mattock/cheiroballistra/README.md

cheiroballistra
===============

Various data related to the cheiroballistra project, such as CAD drawings, wiki 
backups and statistics.

The project wiki is located here:

* http://ballista.wikia.com

And the blog is here:

* http://ballista.wikia.com/wiki/User_blog:Samuli.seppanen
