mattock/cheiroballistra/articles/Juhlakirja/Seppänen, Samuli 2015 - The Cheiroballistra - Abstract.odt

This abstract was originally written for Academia.edu

This paper talks about the challenges of reconstructing the cheiroballistra - a Roman torsion weapon - based on historical manuscripts and archaeological finds. Basic usage of the weapon is also covered. While the reconstruction is already quite powerful, increasing the power output by about 50% should be doable. This will put the weapon roughly in the same category with medieval heavy crossbows, but with much improved rate of fire.
