mattock/cheiroballistra/articles/Juhlakirja/320hz ballista overview 1 - large.png

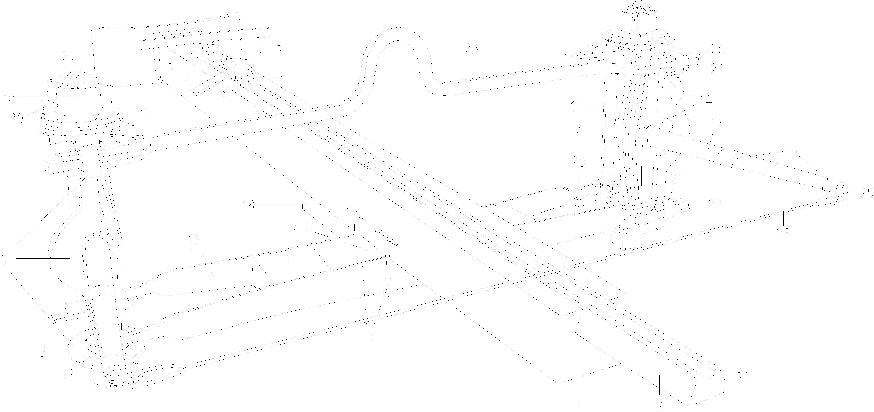
articles/Juhlakirja/320hz ballista overview 1 - large.png
