mattock/cheiroballistra/articles/Juhlakirja/320hz ballista overview 2 - large.png

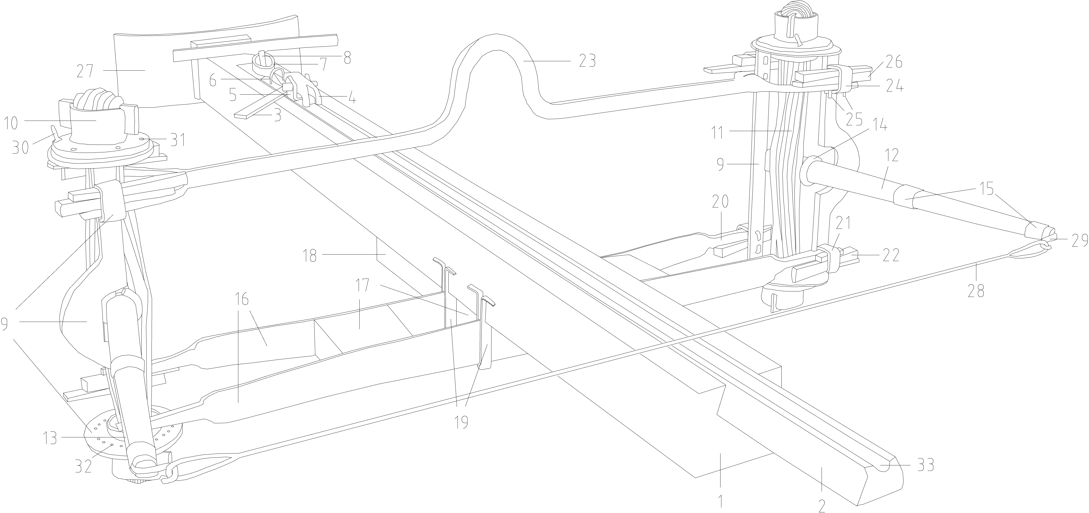
articles/Juhlakirja/320hz ballista overview 2 - large.png
