mattock/cheiroballistra/export/visualization/Cheiroballistra 11 dactyl arm design.png

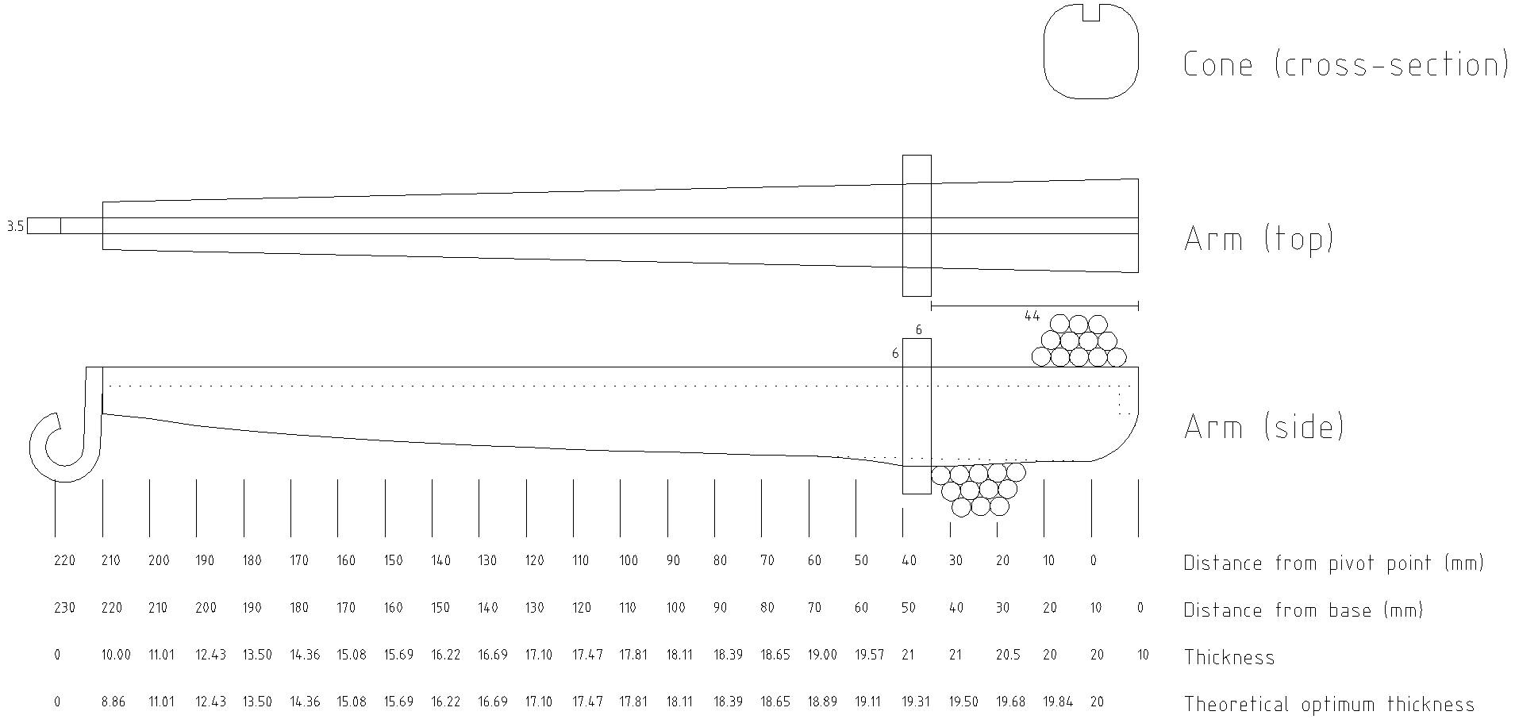
export/visualization/Cheiroballistra 11 dactyl arm design.png
