mattock/cheiroballistra/export/visualization/Cheiroballistra 14 dactyl arm design.png

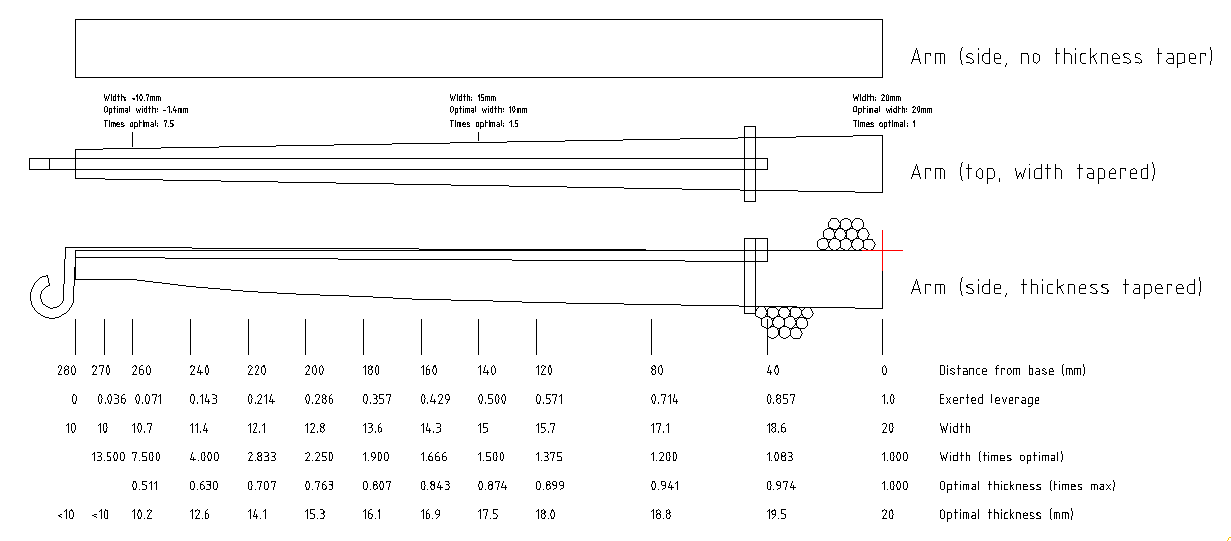
export/visualization/Cheiroballistra 14 dactyl arm design.png
