mattock/cheiroballistra/export/visualization/Cheiroballistra force-draw curves.png

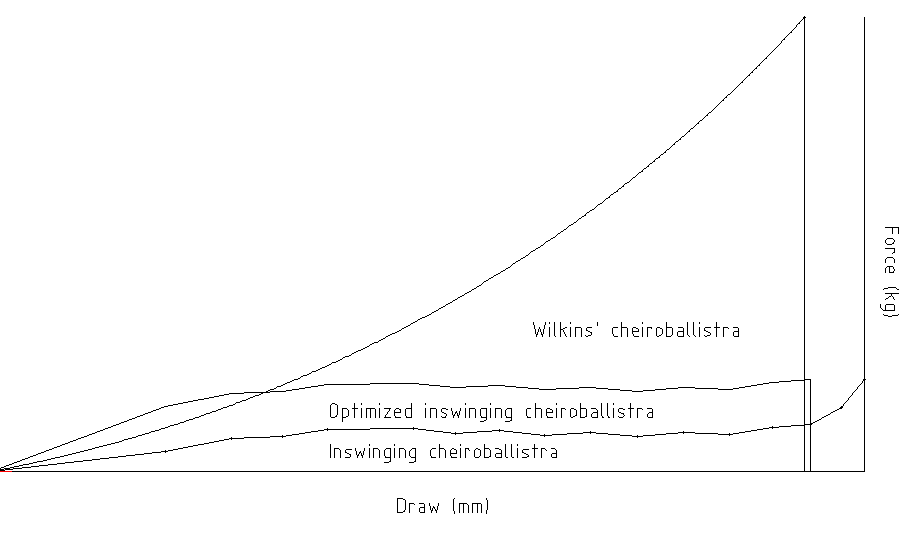
export/visualization/Cheiroballistra force-draw curves.png
