mattock/cheiroballistra/export/visualization/Forces acting on the little arch.png

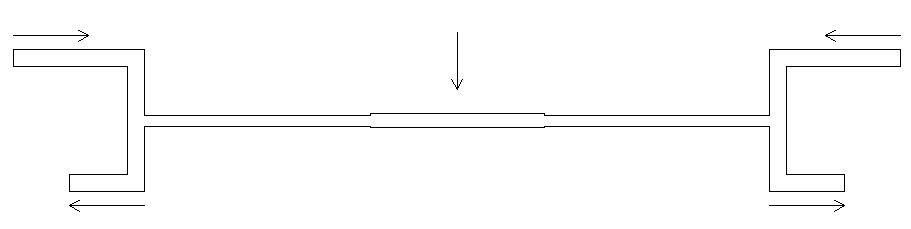
export/visualization/Forces acting on the little arch.png
