mattock/cheiroballistra/export/visualization/Forces acting on the little ladder.png

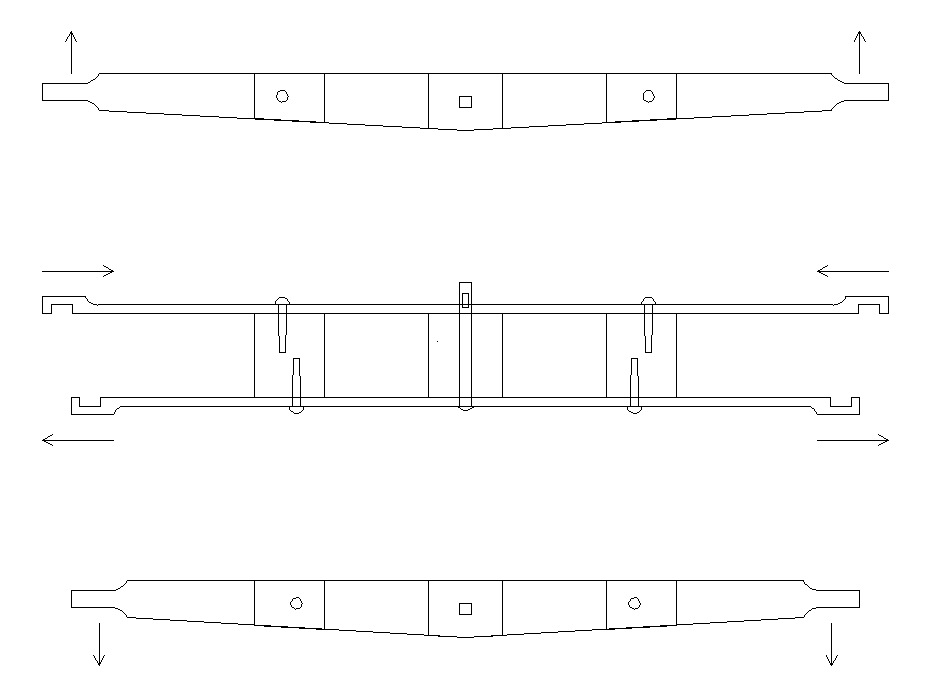
export/visualization/Forces acting on the little ladder.png
