mattock/cheiroballistra/export/visualization/Inswinging_cheiroballistra_arm_travel.png

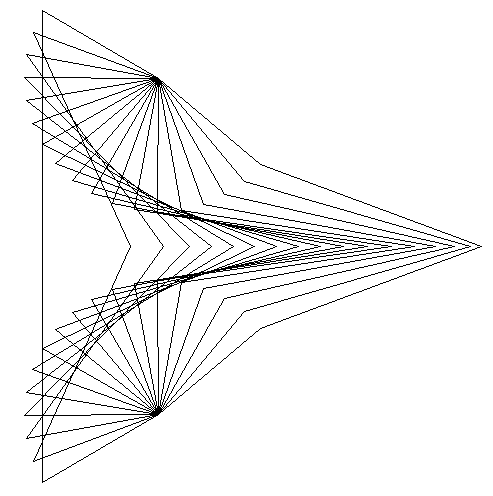
export/visualization/Inswinging_cheiroballistra_arm_travel.png
