mattock/cheiroballistra/export/visualization/Inswinging_cheiroballistra_bowstring_travel.png

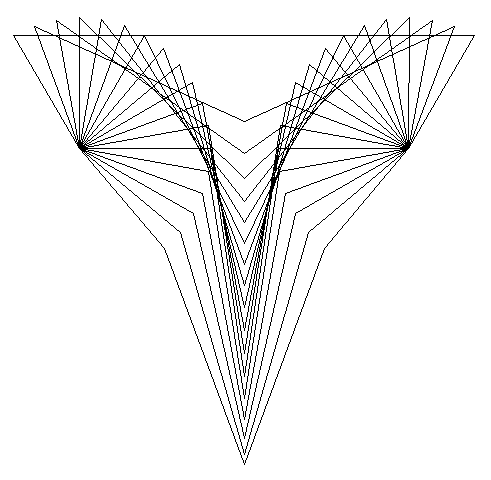
export/visualization/Inswinging_cheiroballistra_bowstring_travel.png
