mattock/cheiroballistra/export/visualization/outswinger visualization.png

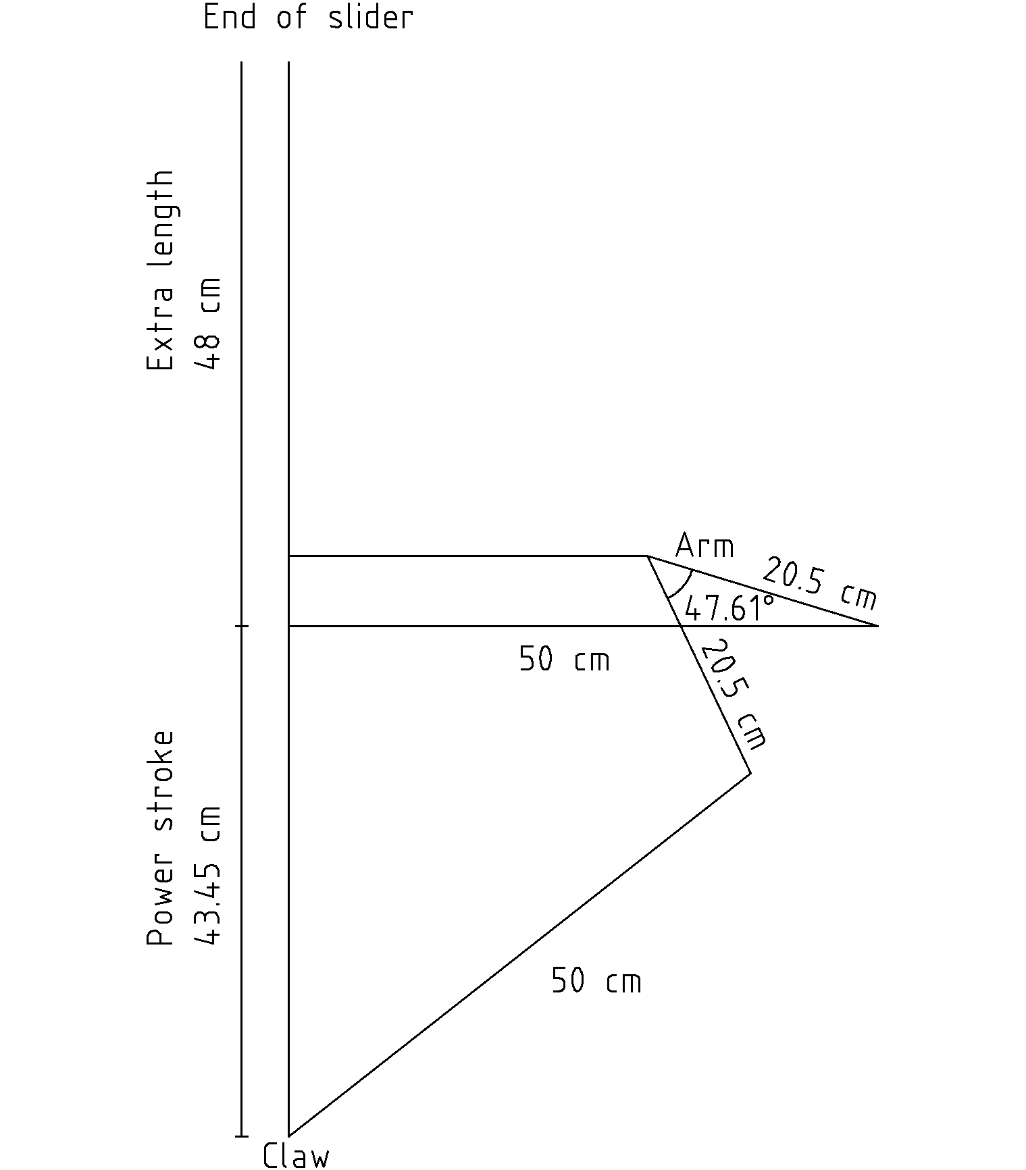
export/visualization/outswinger visualization.png
