mattock/cheiroballistra/export/visualization/Wilkins-cheiroballistra-force-draw-curve.png

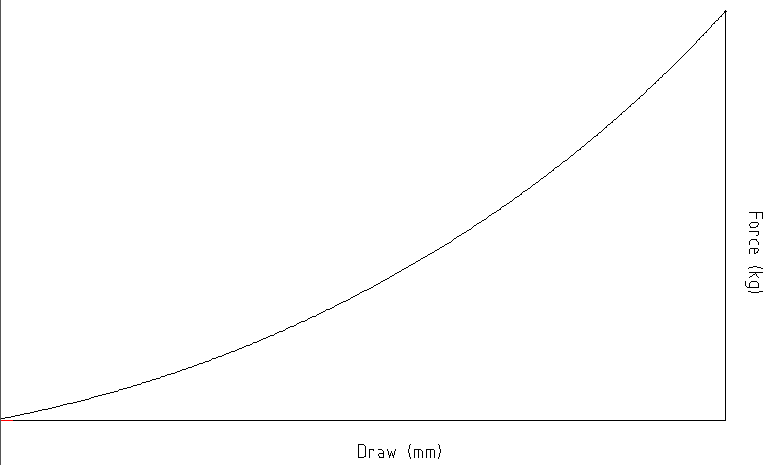
export/visualization/Wilkins-cheiroballistra-force-draw-curve.png
