mattock/cheiroballistra/export/parts/Cheiroballistra arm.png

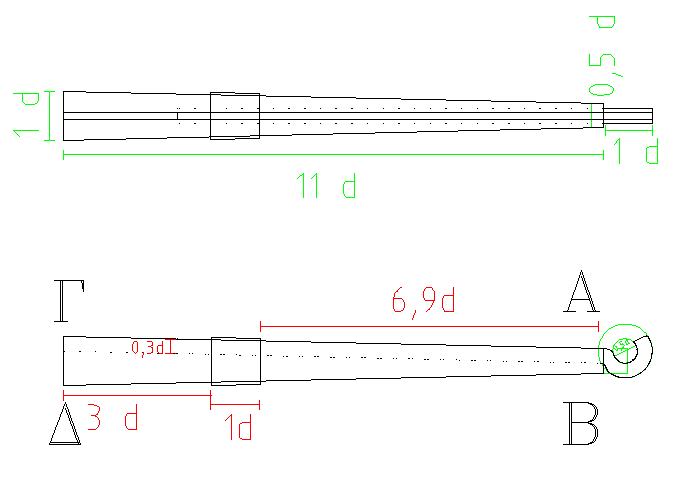
export/parts/Cheiroballistra arm.png
