mattock/cheiroballistra/export/parts/Cheiroballistra case - front.png

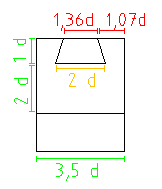
export/parts/Cheiroballistra case - front.png
