mattock/cheiroballistra/export/parts/Cheiroballistra case.png

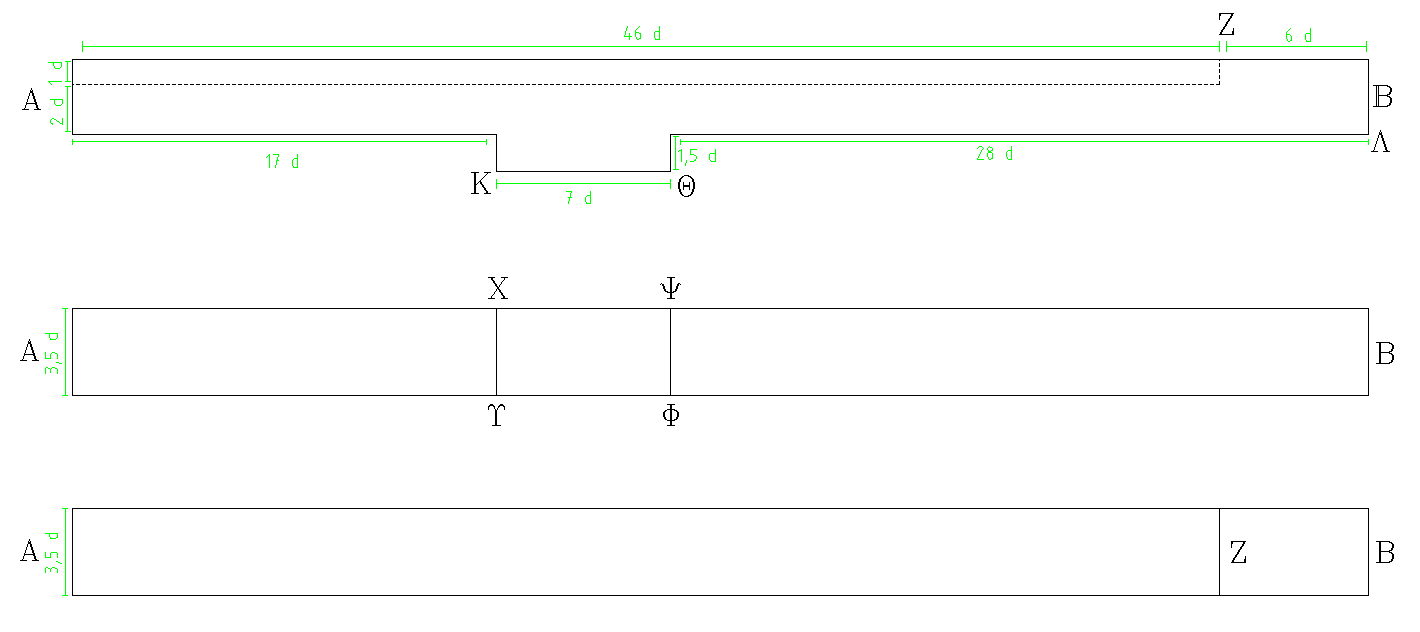
export/parts/Cheiroballistra case.png
