mattock/cheiroballistra/export/parts/Cheiroballistra slider.png

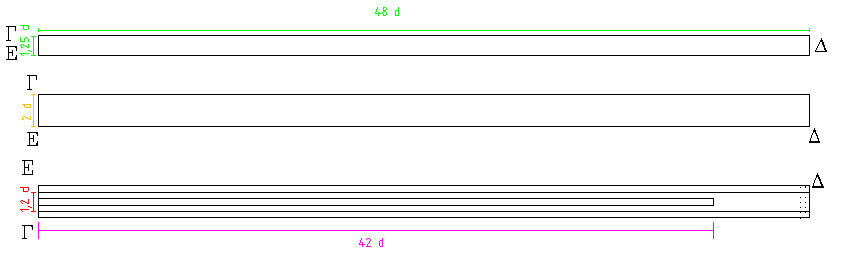
export/parts/Cheiroballistra slider.png
