mattock/cheiroballistra/export/parts/Cheiroballistra_alternative_rungs.png

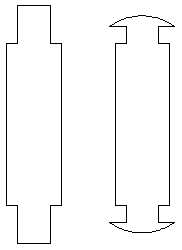
export/parts/Cheiroballistra_alternative_rungs.png
