mattock/cheiroballistra/export/parts/Cheiroballistra_Claw.png

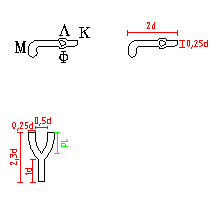
export/parts/Cheiroballistra_Claw.png
