mattock/cheiroballistra/export/parts/Cheiroballistra_Crescent_shaped_piece.png

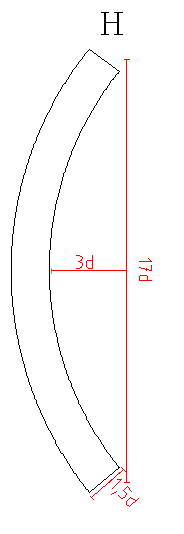
export/parts/Cheiroballistra_Crescent_shaped_piece.png
