mattock/cheiroballistra/export/parts/Cheiroballistra_Field-frame_bars.png

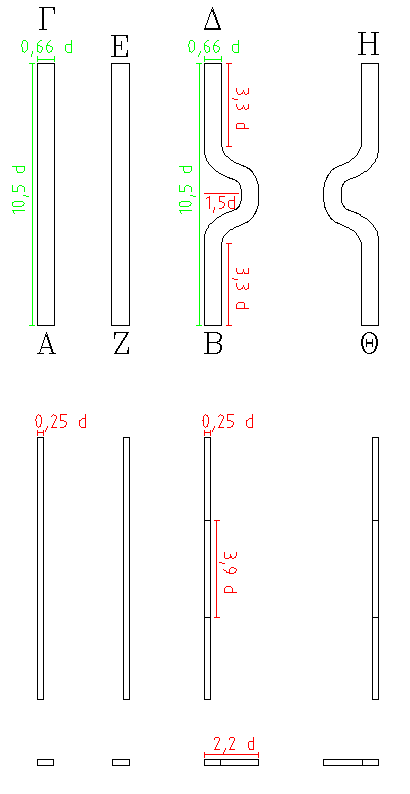
export/parts/Cheiroballistra_Field-frame_bars.png
