mattock/cheiroballistra/export/parts/Cheiroballistra_Field-frame_rings.png

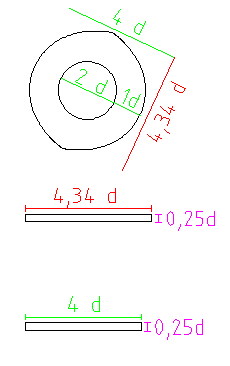
export/parts/Cheiroballistra_Field-frame_rings.png
