mattock/cheiroballistra/export/parts/Cheiroballistra_Fork.png

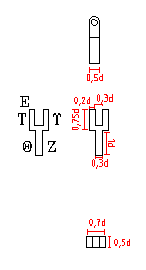
export/parts/Cheiroballistra_Fork.png
