mattock/cheiroballistra/export/parts/Cheiroballistra_front.png

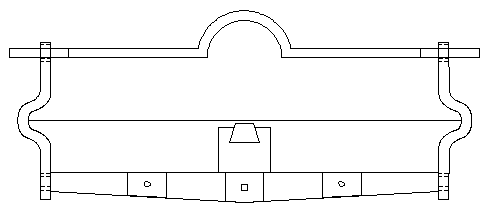
export/parts/Cheiroballistra_front.png
