mattock/cheiroballistra/export/parts/Cheiroballistra_Handle.png

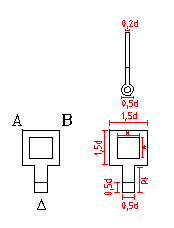
export/parts/Cheiroballistra_Handle.png
