mattock/cheiroballistra/export/parts/Cheiroballistra_Little_Arch.png

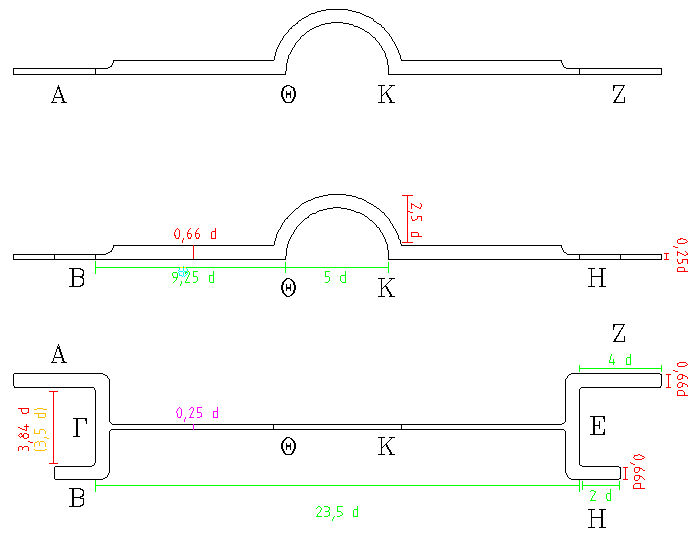
export/parts/Cheiroballistra_Little_Arch.png
