mattock/cheiroballistra/export/parts/Cheiroballistra_Little_Ladder - back and side.png

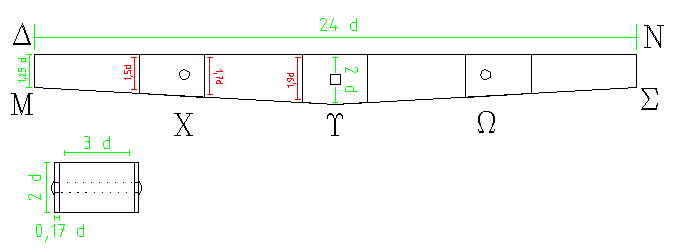
export/parts/Cheiroballistra_Little_Ladder - back and side.png
