mattock/cheiroballistra/export/parts/Cheiroballistra_Little_Ladder - front and top.png

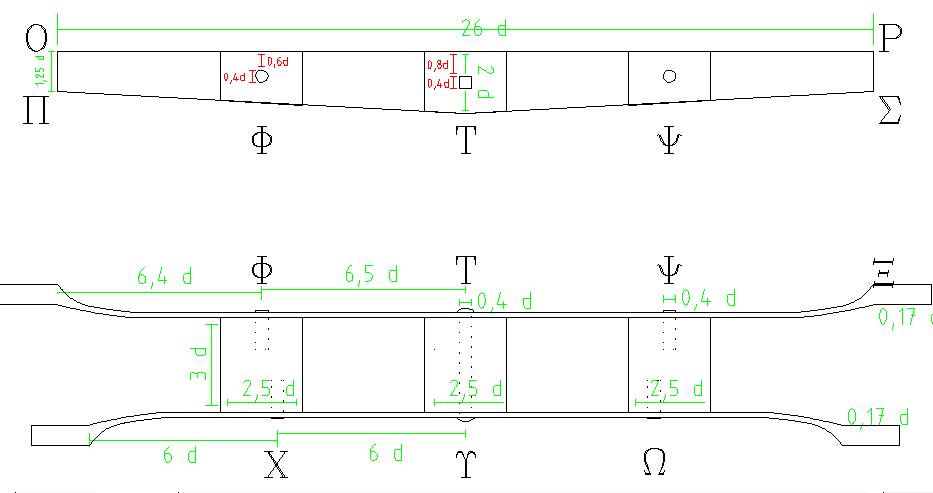
export/parts/Cheiroballistra_Little_Ladder - front and top.png
