mattock/cheiroballistra/export/parts/Cheiroballistra_Little_Ladder.png

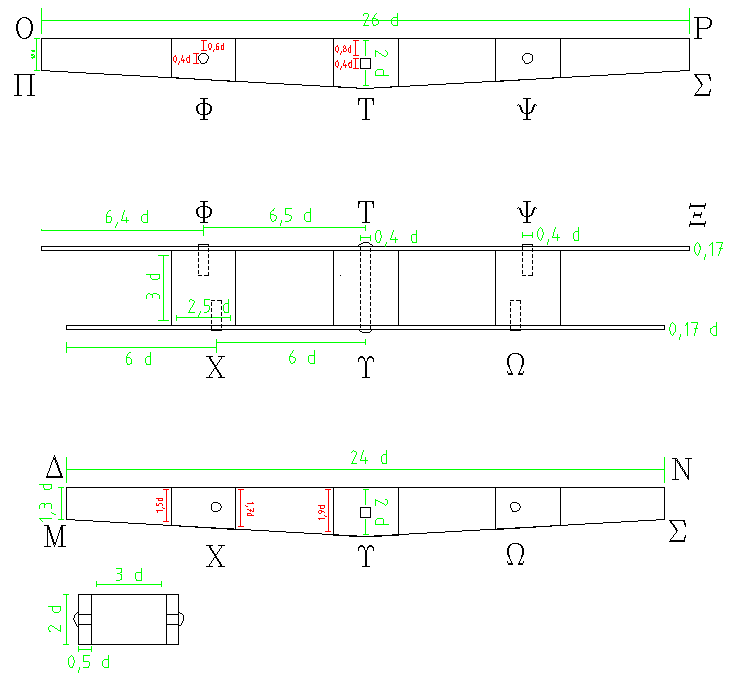
export/parts/Cheiroballistra_Little_Ladder.png
