mattock/cheiroballistra/export/parts/Cheiroballistra_pitarion.png

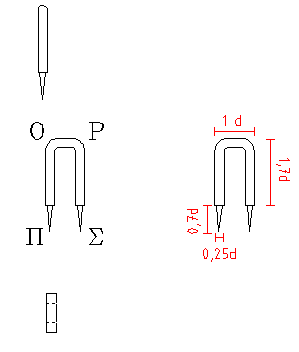
export/parts/Cheiroballistra_pitarion.png
