mattock/cheiroballistra/export/parts/Cheiroballistra_T-clamp.png

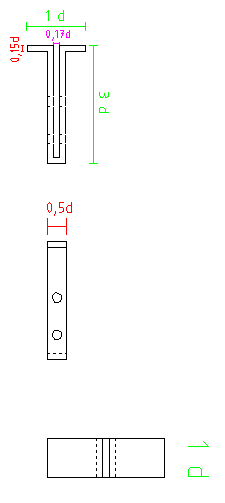
export/parts/Cheiroballistra_T-clamp.png
