mattock/cheiroballistra/export/parts/Cheiroballistra_top_with_field_frames_and_arms.png

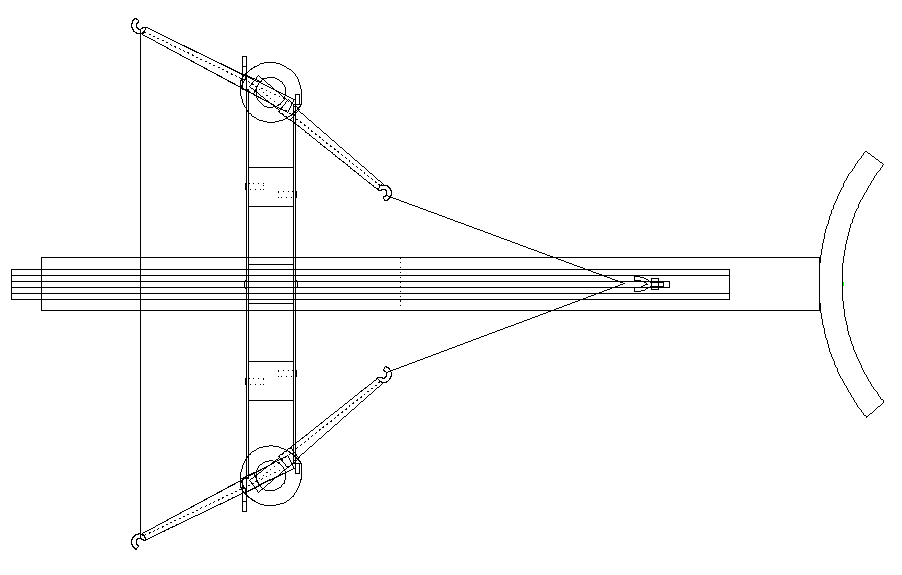
export/parts/Cheiroballistra_top_with_field_frames_and_arms.png
