mattock/cheiroballistra/export/parts/Cheiroballistra_Trigger.png

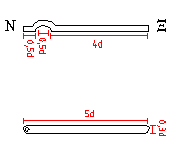
export/parts/Cheiroballistra_Trigger.png
