mattock/cheiroballistra/export/parts/Cheiroballistra_Washers.png

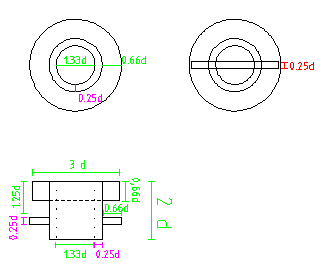
export/parts/Cheiroballistra_Washers.png
