mattock/cheiroballistra/export/parts/field-frame bar placement template.png

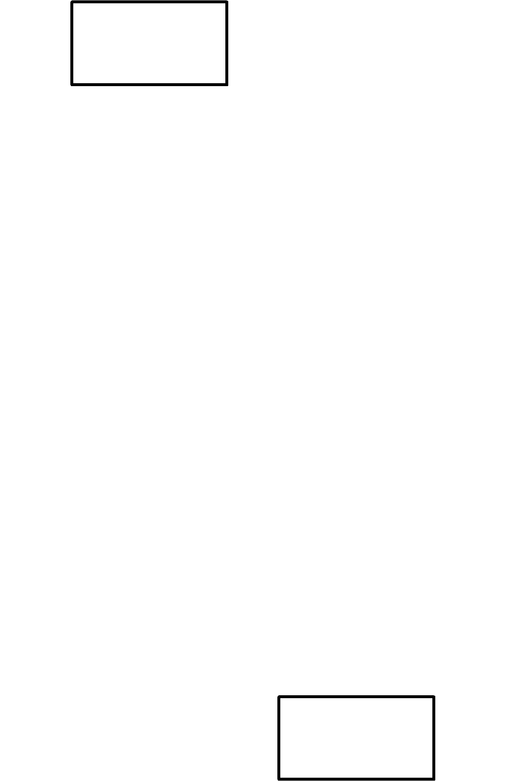
export/parts/field-frame bar placement template.png
