mattock/cheiroballistra/export/parts/field-frame ring template.png

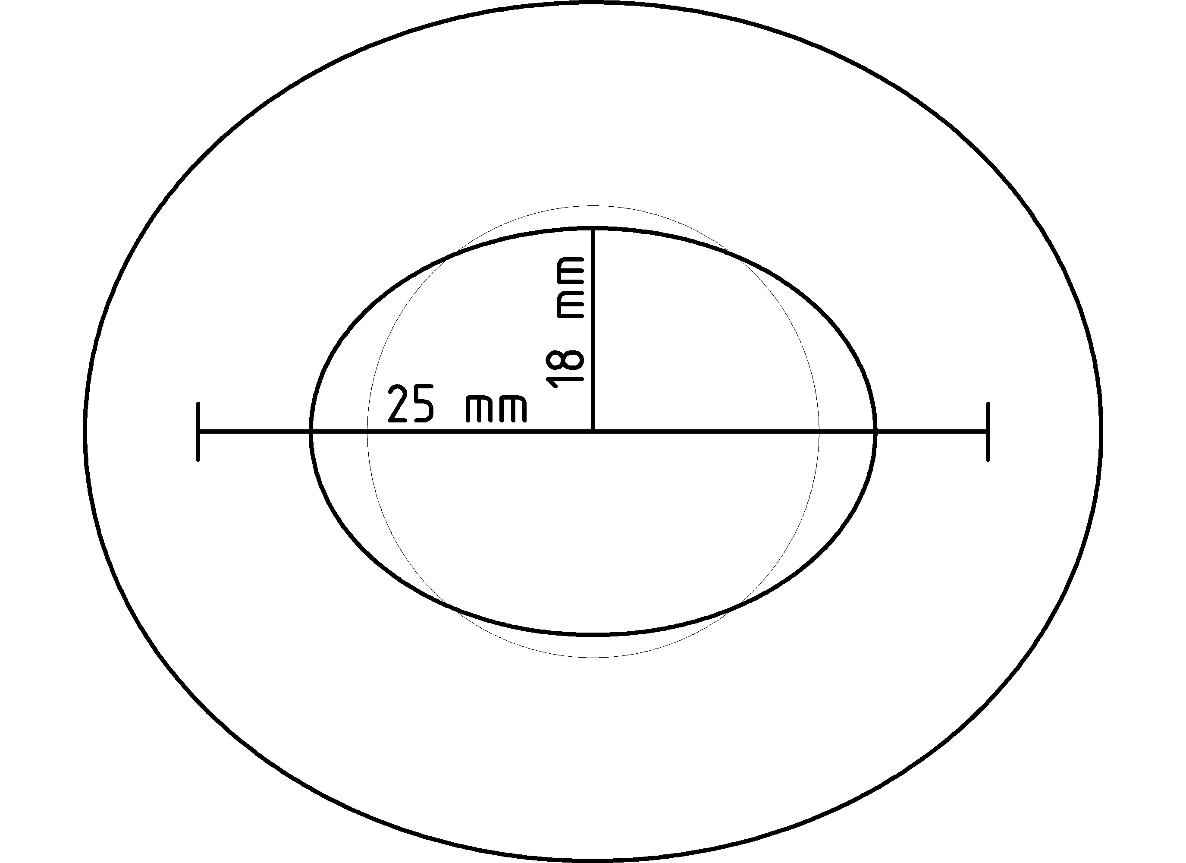
export/parts/field-frame ring template.png
