mattock/cheiroballistra/export/parts/Fitting rope in washers.png

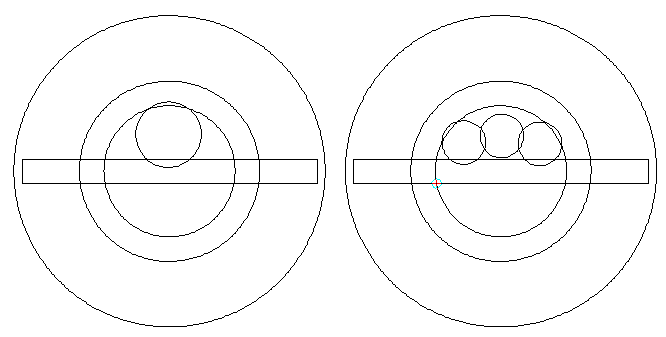
export/parts/Fitting rope in washers.png
