mattock/cheiroballistra/export/parts/Little arch - back.png

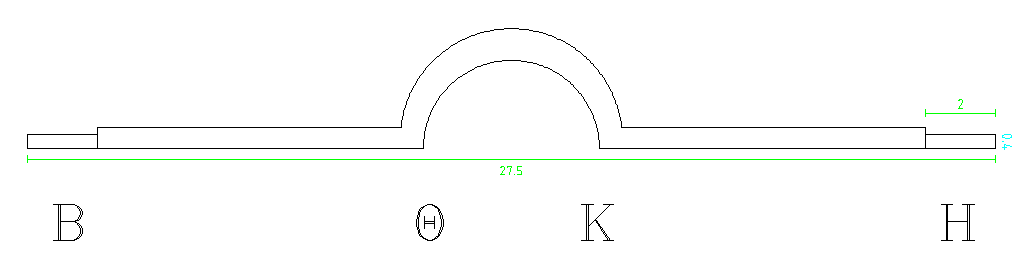
export/parts/Little arch - back.png
