mattock/cheiroballistra/export/parts/Little arch - front.png

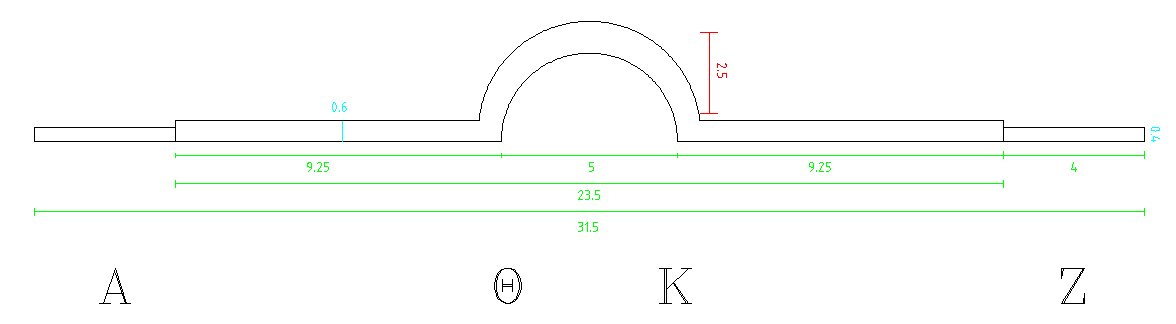
export/parts/Little arch - front.png
