mattock/cheiroballistra/export/parts/Little arch - top.png

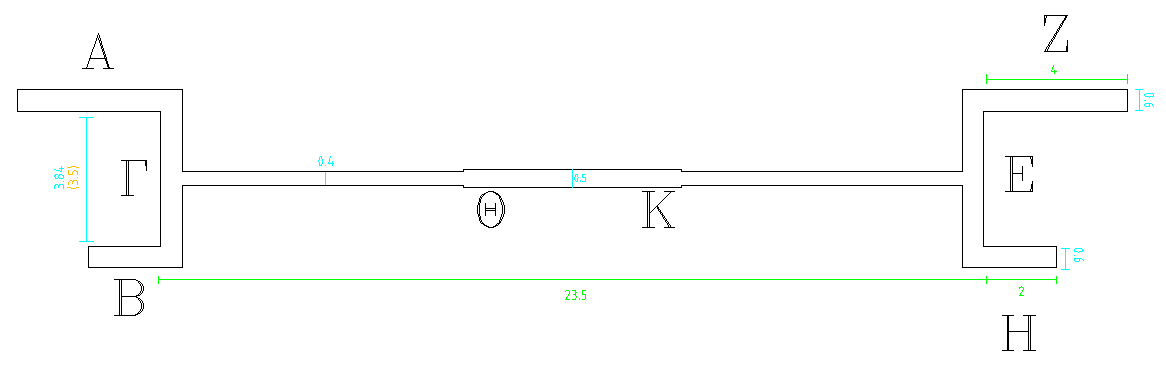
export/parts/Little arch - top.png
