mattock/cheiroballistra/export/parts/Little ladder - back.png

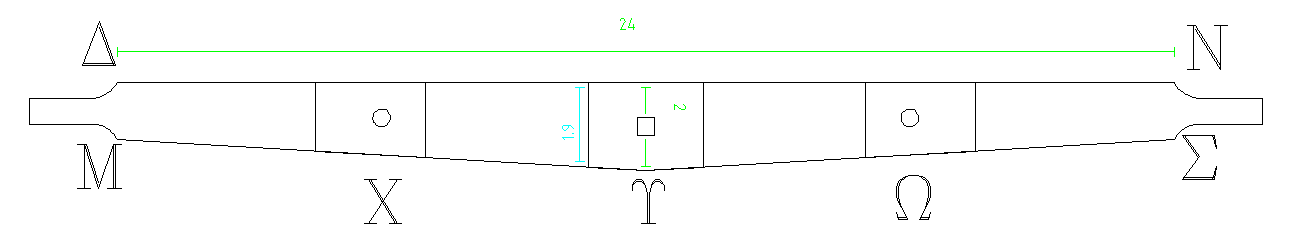
export/parts/Little ladder - back.png
