mattock/cheiroballistra/export/parts/Little ladder - front.png

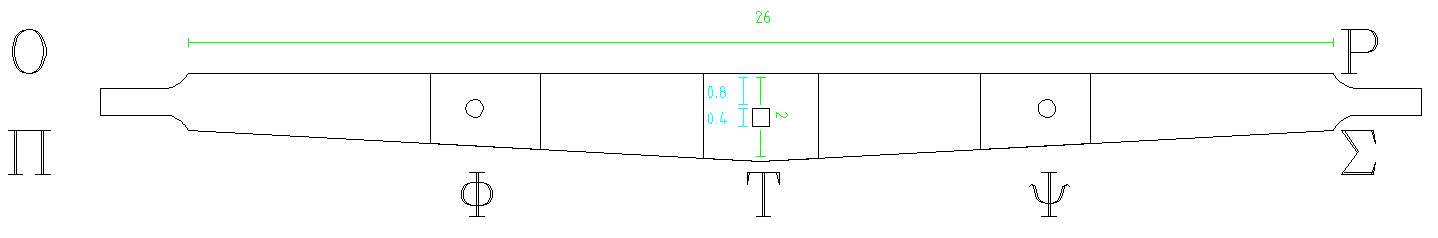
export/parts/Little ladder - front.png
