mattock/cheiroballistra/export/parts/Little ladder - top.png

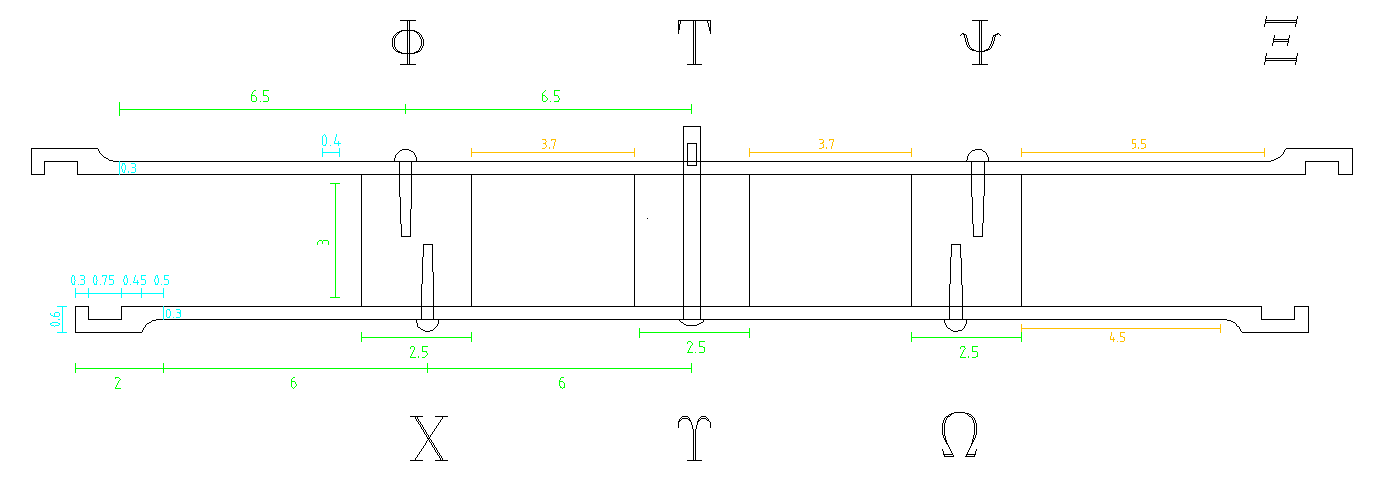
export/parts/Little ladder - top.png
