mattock/cheiroballistra/export/parts/Outswinging_cheiroballistra_arm_travel.png

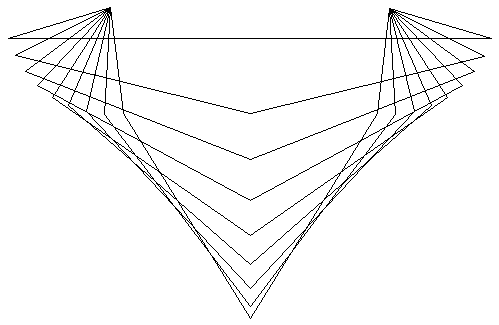
export/parts/Outswinging_cheiroballistra_arm_travel.png
