mattock/cheiroballistra/export/parts/T-clamps from front.png

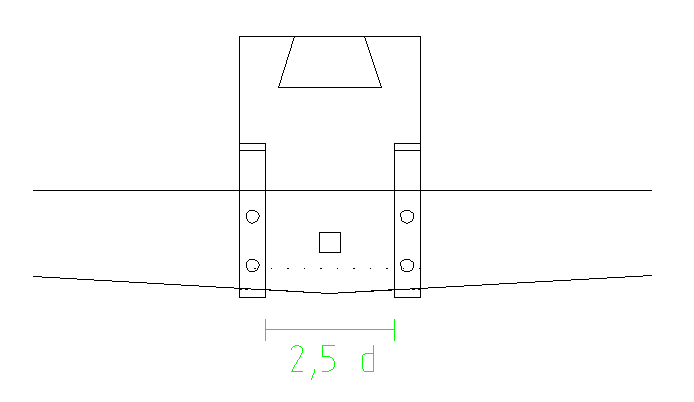
export/parts/T-clamps from front.png
