mattock/cheiroballistra/export/parts/T-clamps from side.png

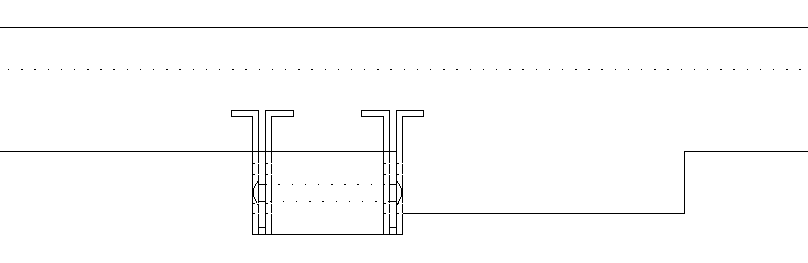
export/parts/T-clamps from side.png
