mattock/cheiroballistra/articles/Juhlakirja/320hz ballista overview.dxf

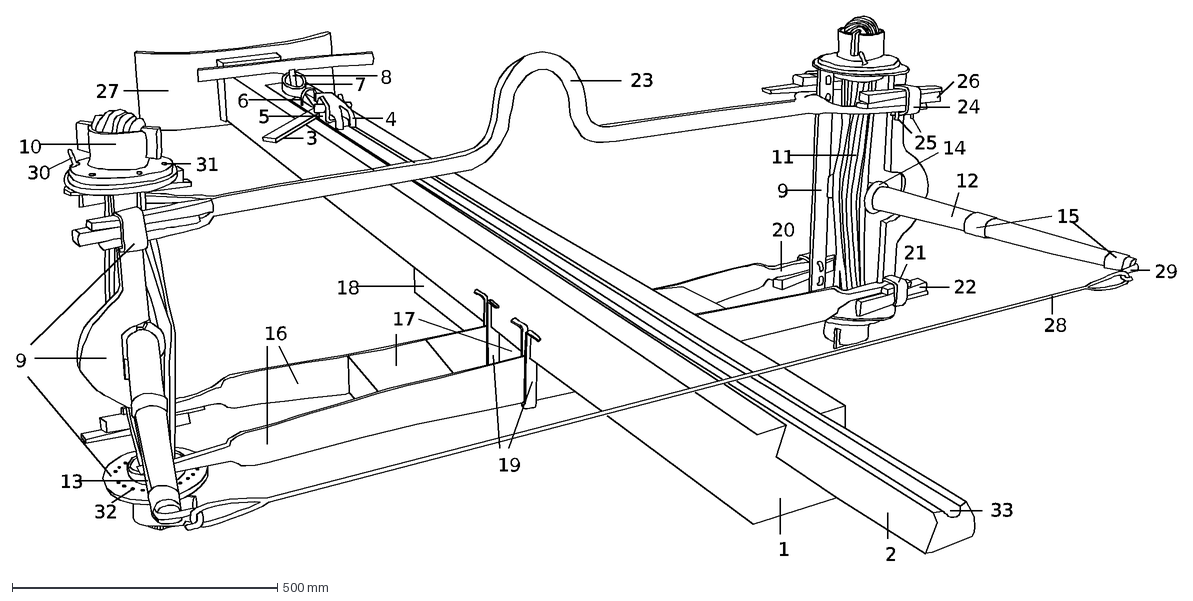
[picture p45: CAD file, 2015-10-14]
articles/Juhlakirja/320hz ballista overview.dxf
4
3
5
6
7
8
15
14
12
20
21
22
23
24
25
26
27
28
11
16
18
17
19
10
9
13
29
30
31
32
33
2
1
