mattock/cheiroballistra/cad/Cheiroballistra arm design.dxf

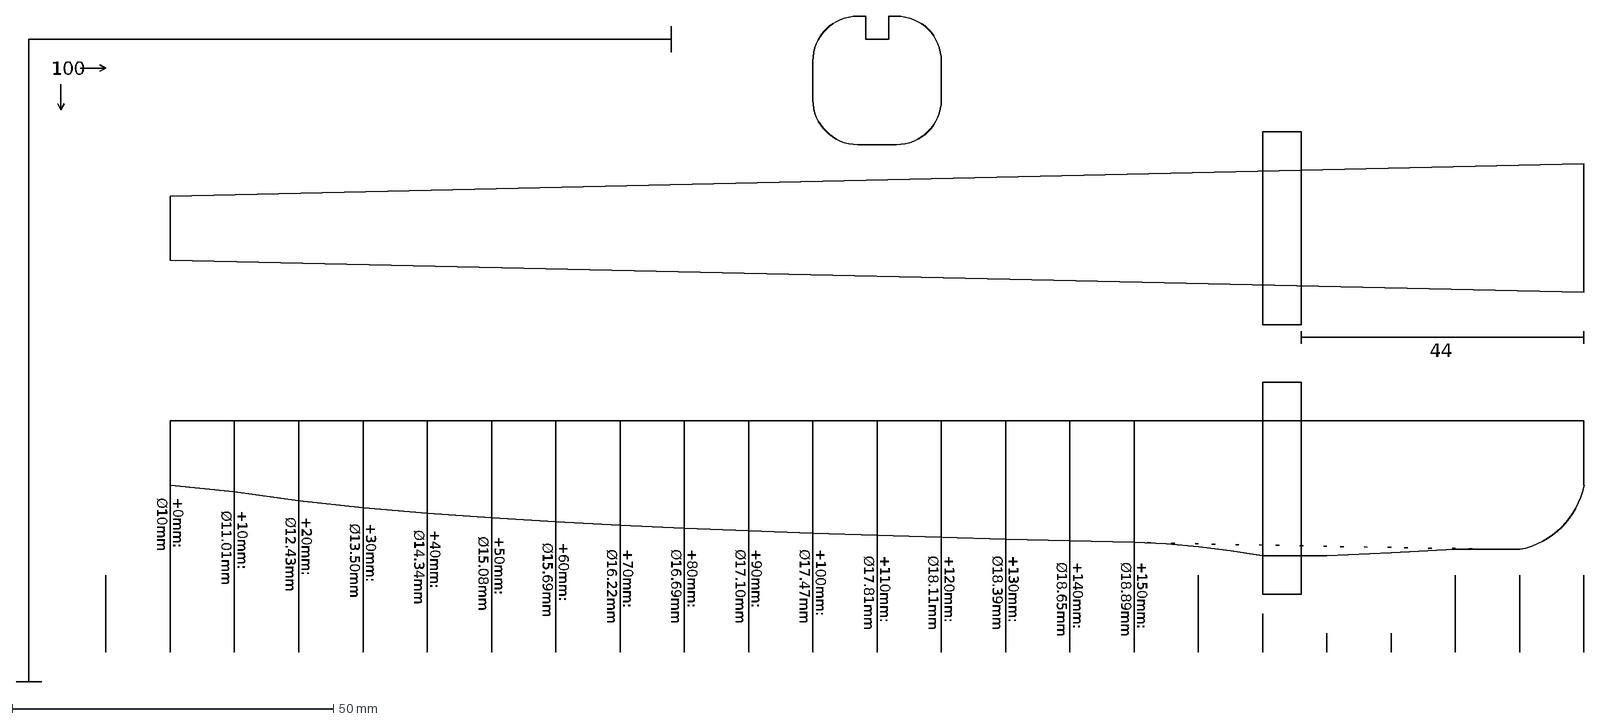
[picture p46: CAD file, 2017-08-24]
cad/Cheiroballistra arm design.dxf
44
100
+0mm: Ø10mm
+10mm: Ø11.01mm
+20mm: Ø12.43mm
+30mm: Ø13.50mm
+40mm: Ø14.34mm
+50mm: Ø15.08mm
+60mm: Ø15.69mm
+70mm: Ø16.22mm
+80mm: Ø16.69mm
+90mm: Ø17.10mm
+100mm: Ø17.47mm
+110mm: Ø17.81mm
+120mm: Ø18.11mm
+130mm: Ø18.39mm
+140mm: Ø18.65mm
+150mm: Ø18.89mm
