mattock/cheiroballistra/cad/cheiroballistra.dxf

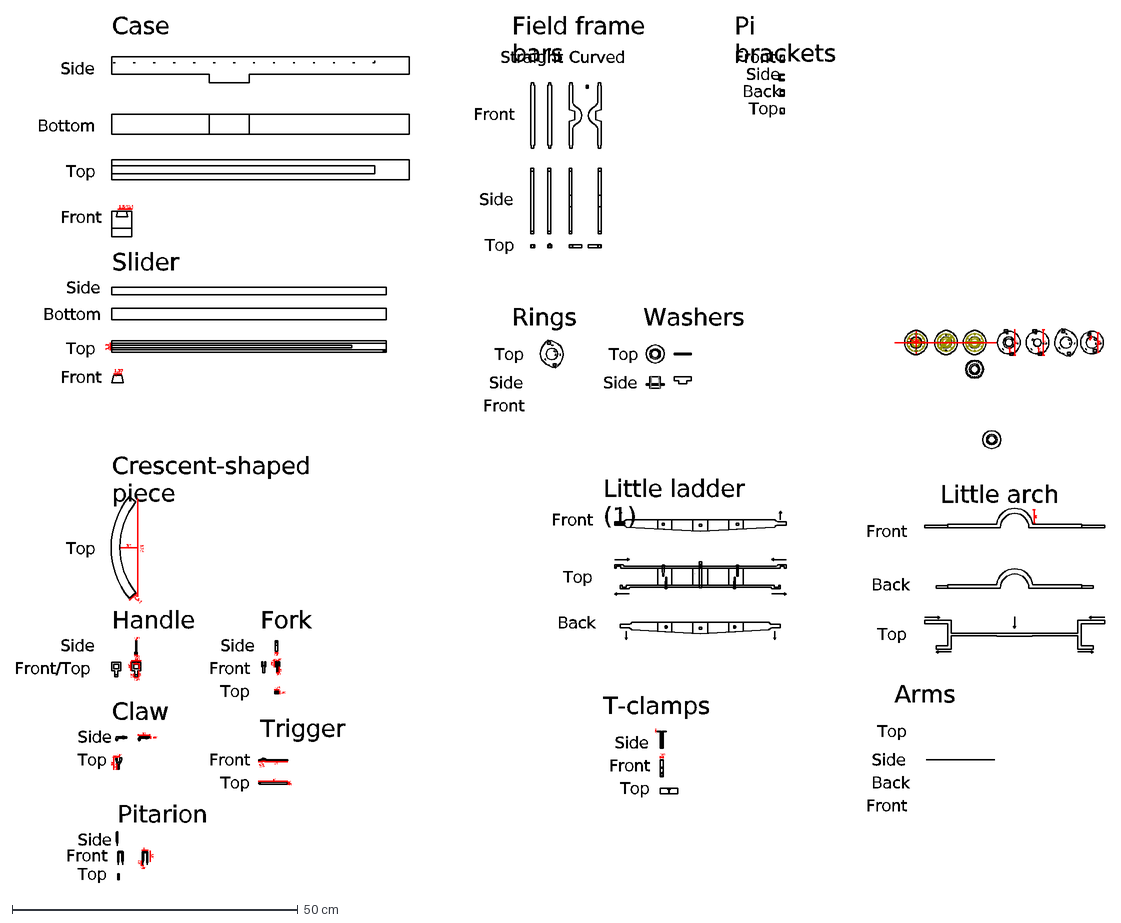
[picture p47: CAD file, 2016-01-12]
cad/cheiroballistra.dxf
Side
Case
Bottom
Top
Field frame bars
Front
Rings
Pi brackets
Back
Crescent-shaped piece
3d
17d
1,5d
1d
0,5d
Handle
Front/Top
Fork
0,75d
0,3d
0,2d
0,7d
Claw
0,25d
2,3d
2d
Trigger
5d
4d
Pitarion
Slider
Washers
1,2 d
1,7d
1 d
1,37 d
Straight
Curved
1.4d
90°
60°
Little ladder (1)
Little arch
2.5
T-clamps
0,15d
Arms
3.35
4.48
1.08
4.5
1.09
0.52
