mattock/cheiroballistra/cad/Cheiroballistra arm - cone - side.dxf

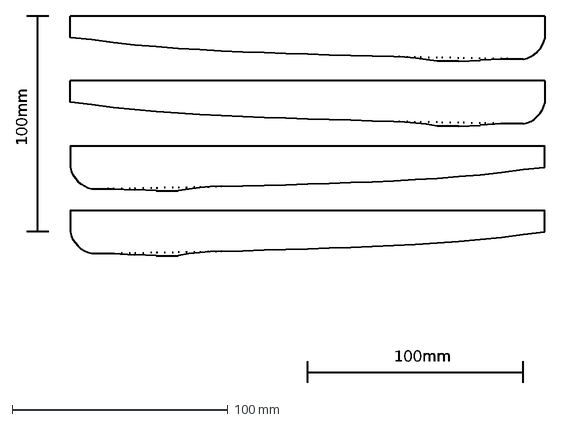
[picture p48: CAD file, 2015-11-29]
cad/Cheiroballistra arm - cone - side.dxf
100mm
