mattock/cheiroballistra/cad/Force-draw curve visualization.dxf

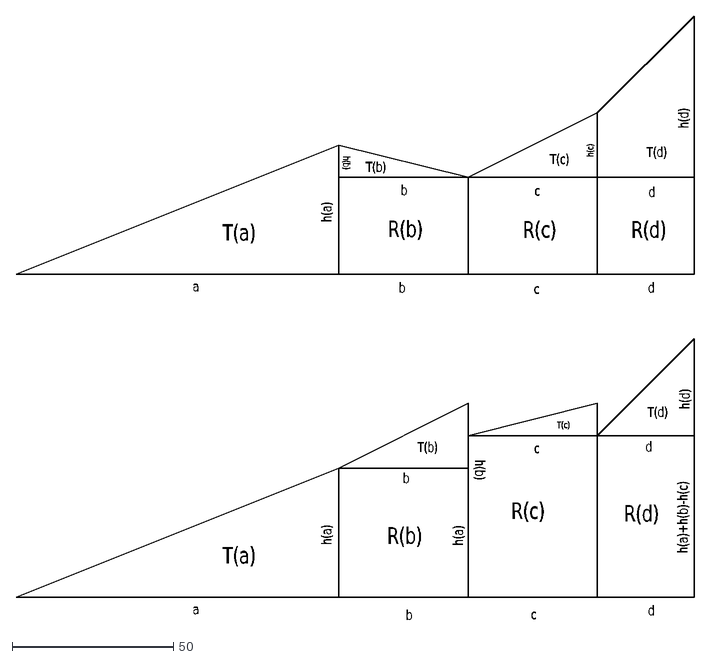
[picture p49: CAD file, 2015-01-18]
cad/Force-draw curve visualization.dxf
T(a)
h(a)
a
b
d
c
T(b)
R(b)
h(a)+h(b)-h(c)
R(d)
h(d)
T(d)
T(c)
R(c)
h(b)
h(c)
