mattock/cheiroballistra/cad/outswinger visualization.dxf

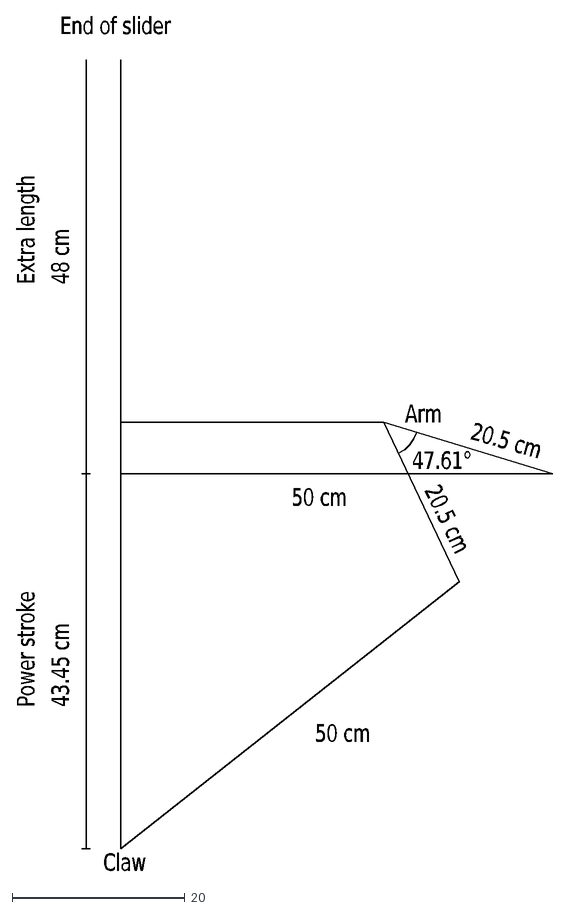
[picture p50: CAD file, 2013-10-18]
cad/outswinger visualization.dxf
43.45 cm
47.61°
50 cm
48 cm
End of slider
Claw
20.5 cm
Arm
Power stroke
Extra length
