mattock/cheiroballistra/cad/clip.dxf

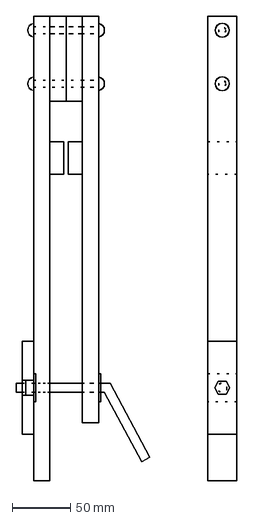
[picture p51: CAD file, 2013-07-07]
cad/clip.dxf
190.0 x 400.0 mm
