mattock/cheiroballistra/cad/stretcher.dxf

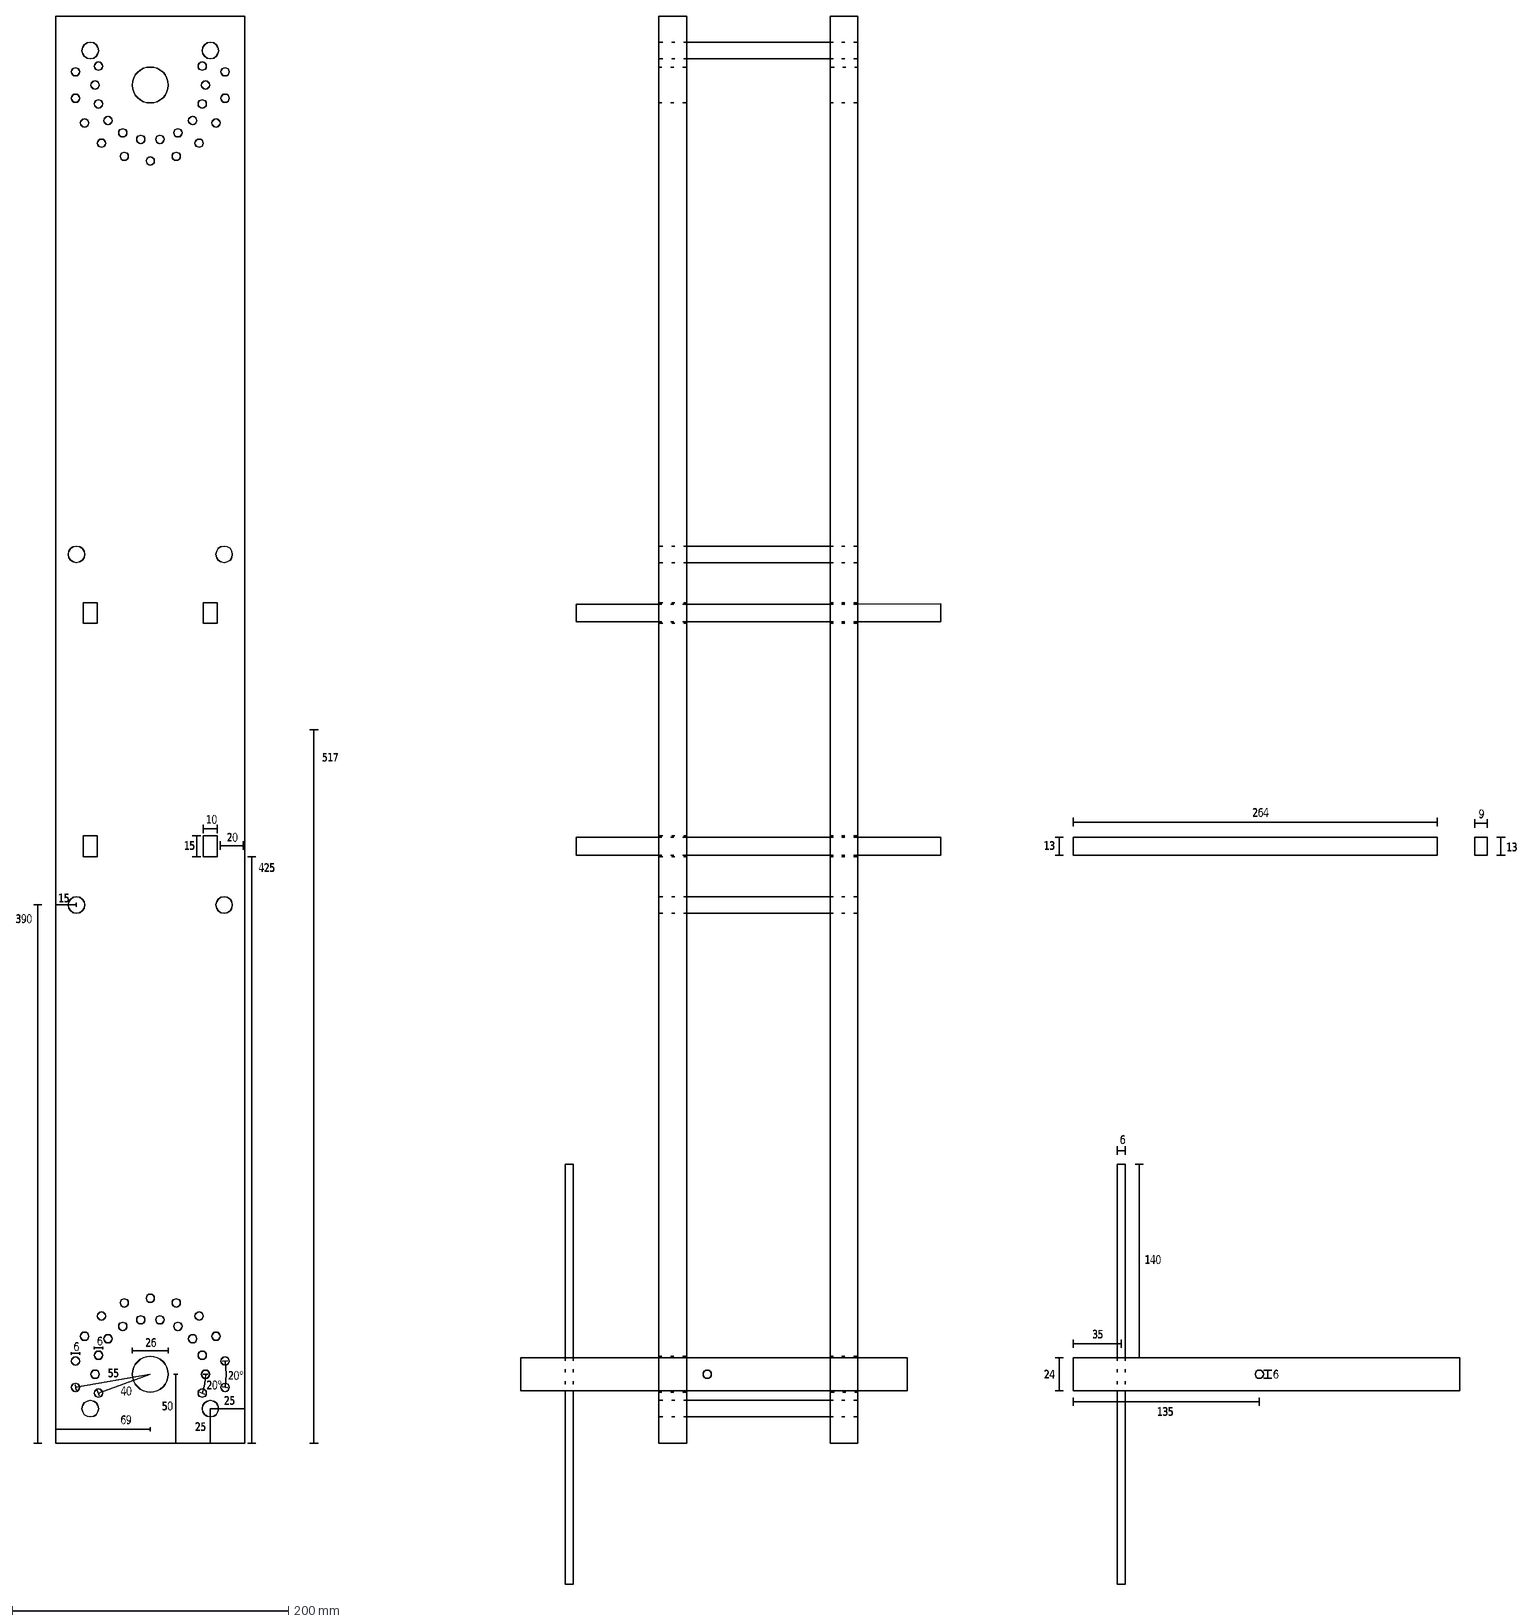
[picture p52: CAD file, 2013-07-07]
cad/stretcher.dxf
20
15
10
425
40
20°
55
6
26
25
517
390
264
13
9
35
135
140
24
50
69
