mattock/cheiroballistra/cad/field-frame ring template.dxf

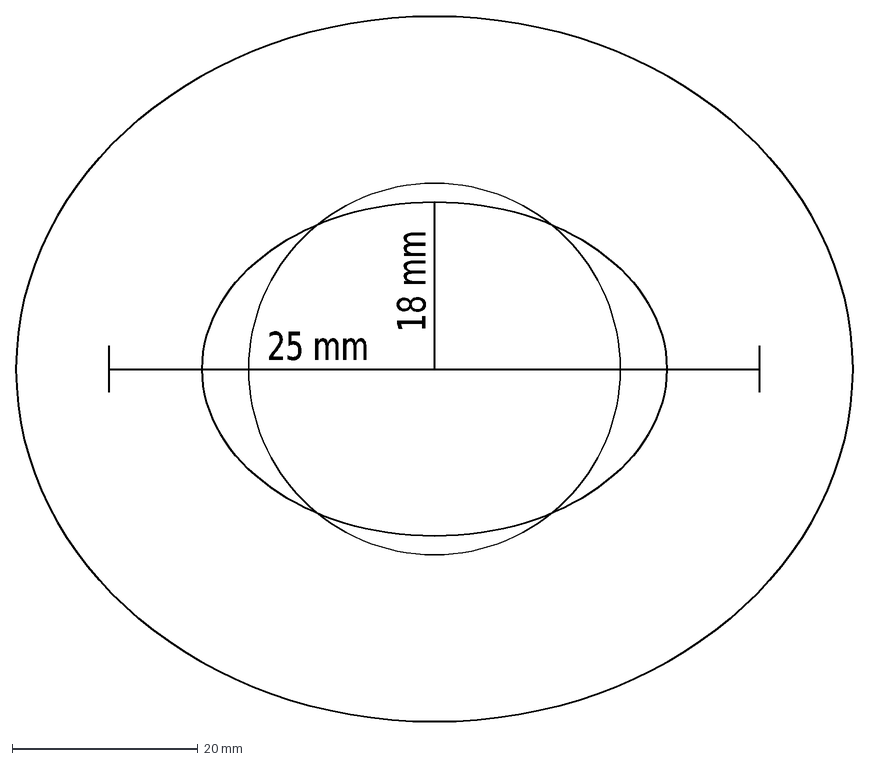
[picture p53: CAD file, 2013-07-07]
cad/field-frame ring template.dxf
18 mm
25 mm
