mattock/cheiroballistra/cad/field-frame bar placement template.dxf

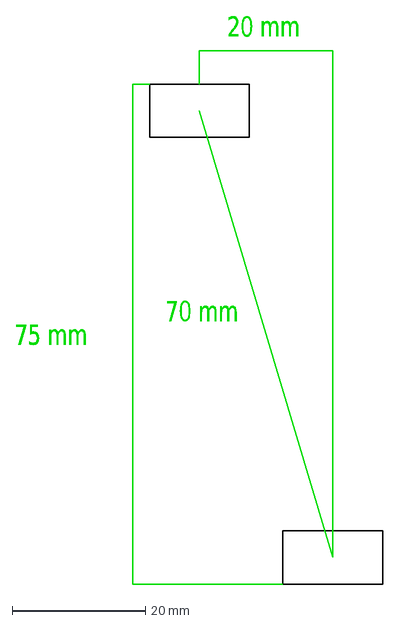
[picture p54: CAD file, 2013-07-07]
cad/field-frame bar placement template.dxf
20 mm
70 mm
75 mm
