mattock/cheiroballistra/export/assembled/Alignment of the field-frame bars.png

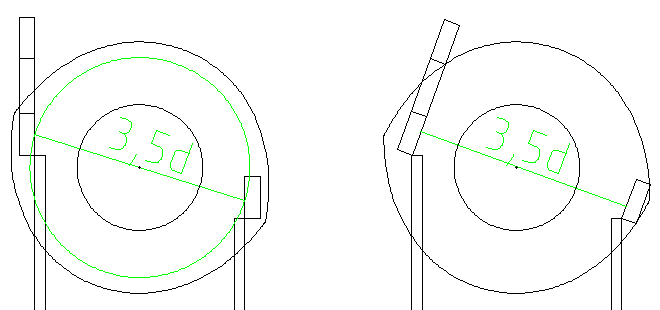
export/assembled/Alignment of the field-frame bars.png
