mattock/cheiroballistra/export/assembled/Attaching the little arch - top.png

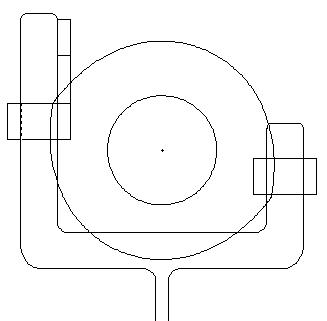
export/assembled/Attaching the little arch - top.png
