mattock/cheiroballistra/export/assembled/Attaching the little ladder tenons to Pi-brackets inside the bars - front.png

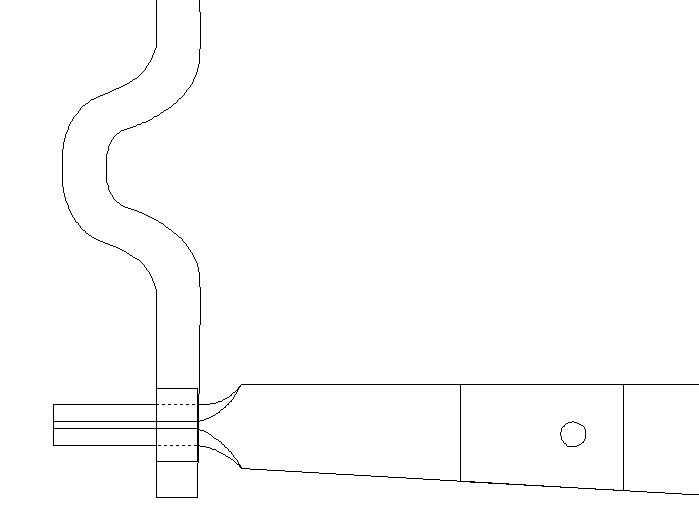
export/assembled/Attaching the little ladder tenons to Pi-brackets inside the bars - front.png
