mattock/cheiroballistra/export/assembled/Attaching the little ladder tenons to Pi-brackets outside the bars - top.png

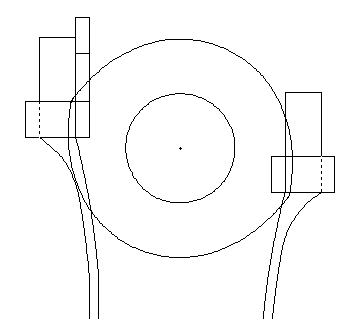
export/assembled/Attaching the little ladder tenons to Pi-brackets outside the bars - top.png
