mattock/cheiroballistra/export/assembled/Cheiroballistra from front with two slider options.png

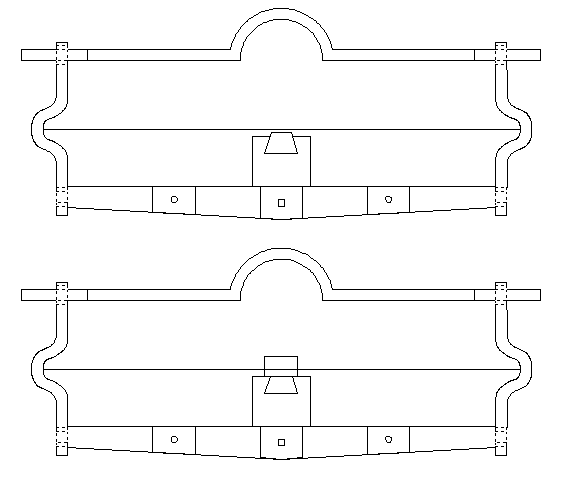
export/assembled/Cheiroballistra from front with two slider options.png
