mattock/cheiroballistra/export/assembled/Inswinger with large arm arc.png

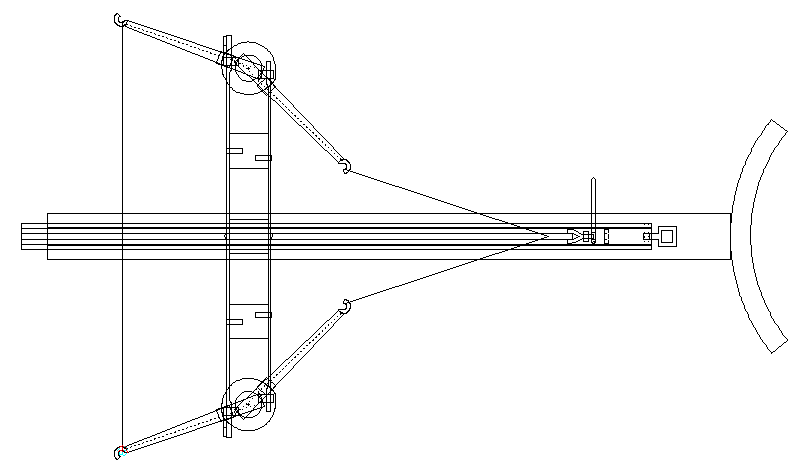
export/assembled/Inswinger with large arm arc.png
