mattock/cheiroballistra/export/assembled/Inswinger with maximum arm arc.png

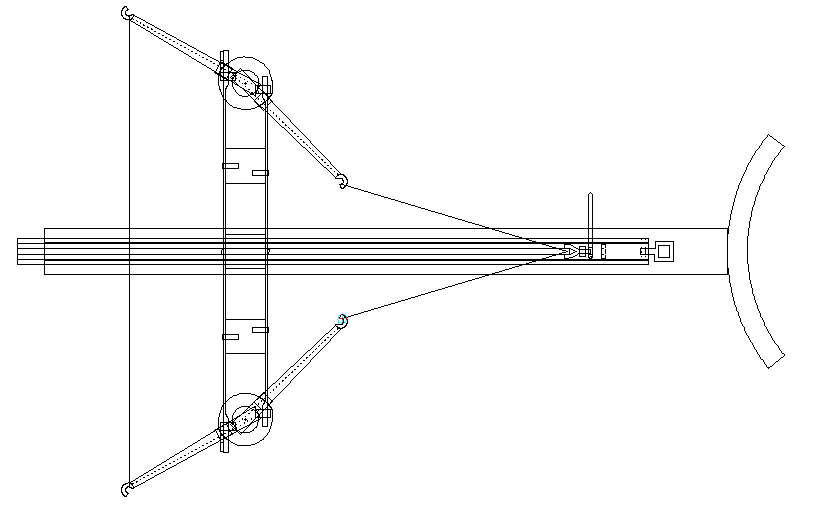
export/assembled/Inswinger with maximum arm arc.png
