mattock/cheiroballistra/export/assembled/Inswinger with small arm arc.png

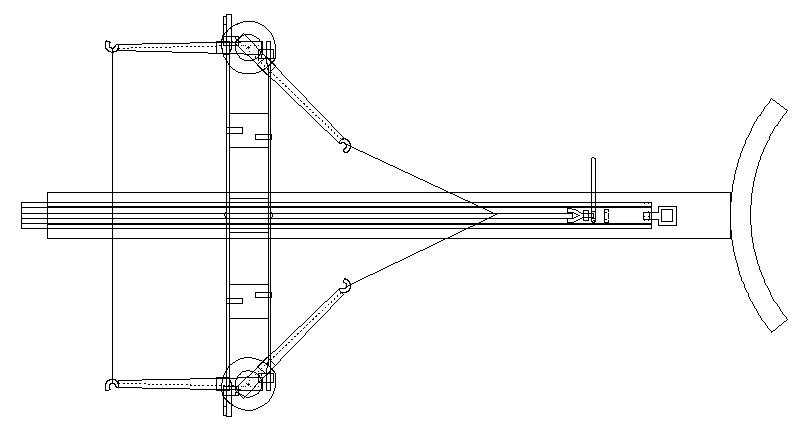
export/assembled/Inswinger with small arm arc.png
