mattock/cheiroballistra/export/assembled/Triggering_mechanism.png

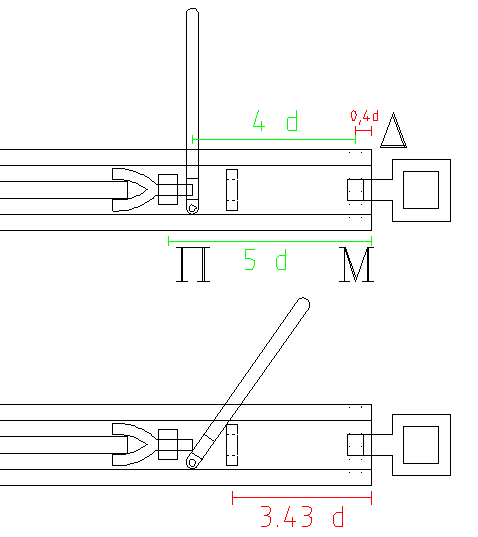
export/assembled/Triggering_mechanism.png
