mattock/cheiroballistra/export/parts/Assembled triggering mechanism.png

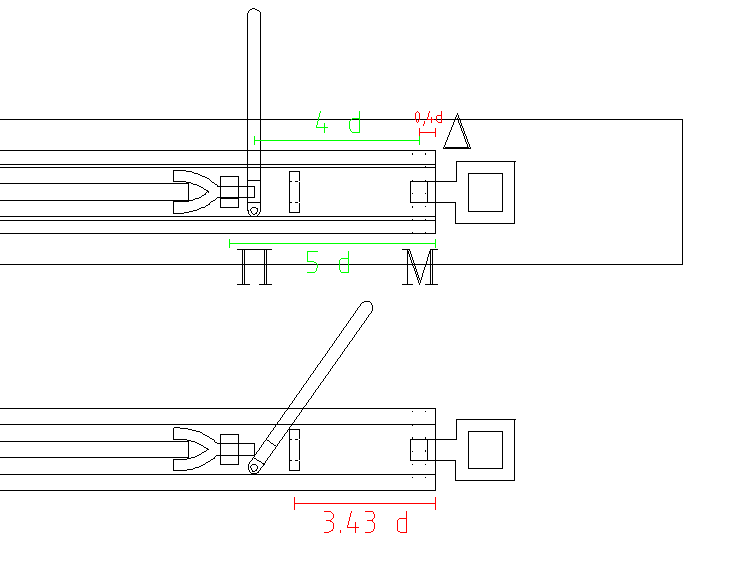
export/parts/Assembled triggering mechanism.png
