mattock/cheiroballistra/statistics/cord stretch tests.ods

Weight | Length | Thickness | Stretch | Contraction
0,5 | 74,9 | 2,1 | 0 | 0,00%
3 | 75,5 |  | 0,80% | 100,00%
5,5 | 75,9 |  | 1,34% | 100,00%
8 | 76,7 |  | 2,40% | 100,00%
10,5 | 77,4 |  | 3,34% | 100,00%
15,5 | 78,8 |  | 5,21% | 100,00%
20,5 | 79,7 |  | 6,41% | 100,00%
25,5 | 80,7 |  | 7,74% | 100,00%
30,5 | 81,2 |  | 8,41% | 100,00%
35,5 | 81,7 | 1,85 | 9,08% | 88,10%
