mattock/cheiroballistra/cad/Cheiroballistra arm - cone - side.pdf

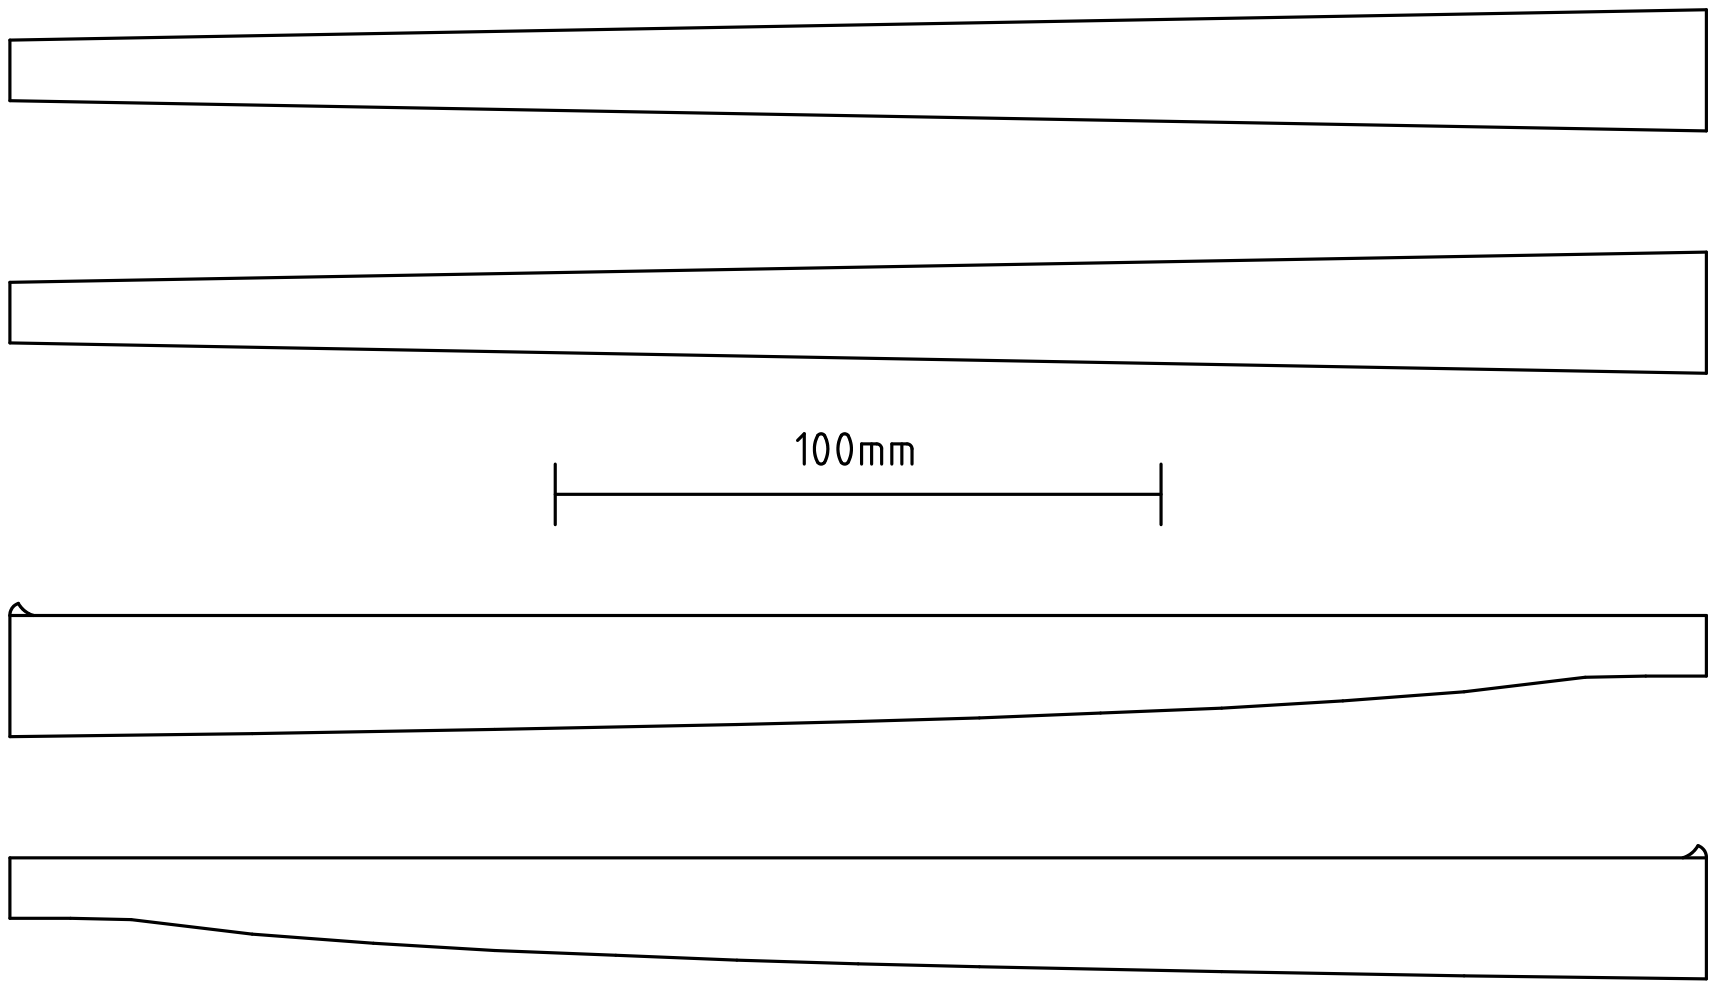
[picture p66: page 1]
