mattock/cheiroballistra/articles/Juhlakirja/Seppänen, Samuli 2015 - The Cheiroballistra - Print version.pdf

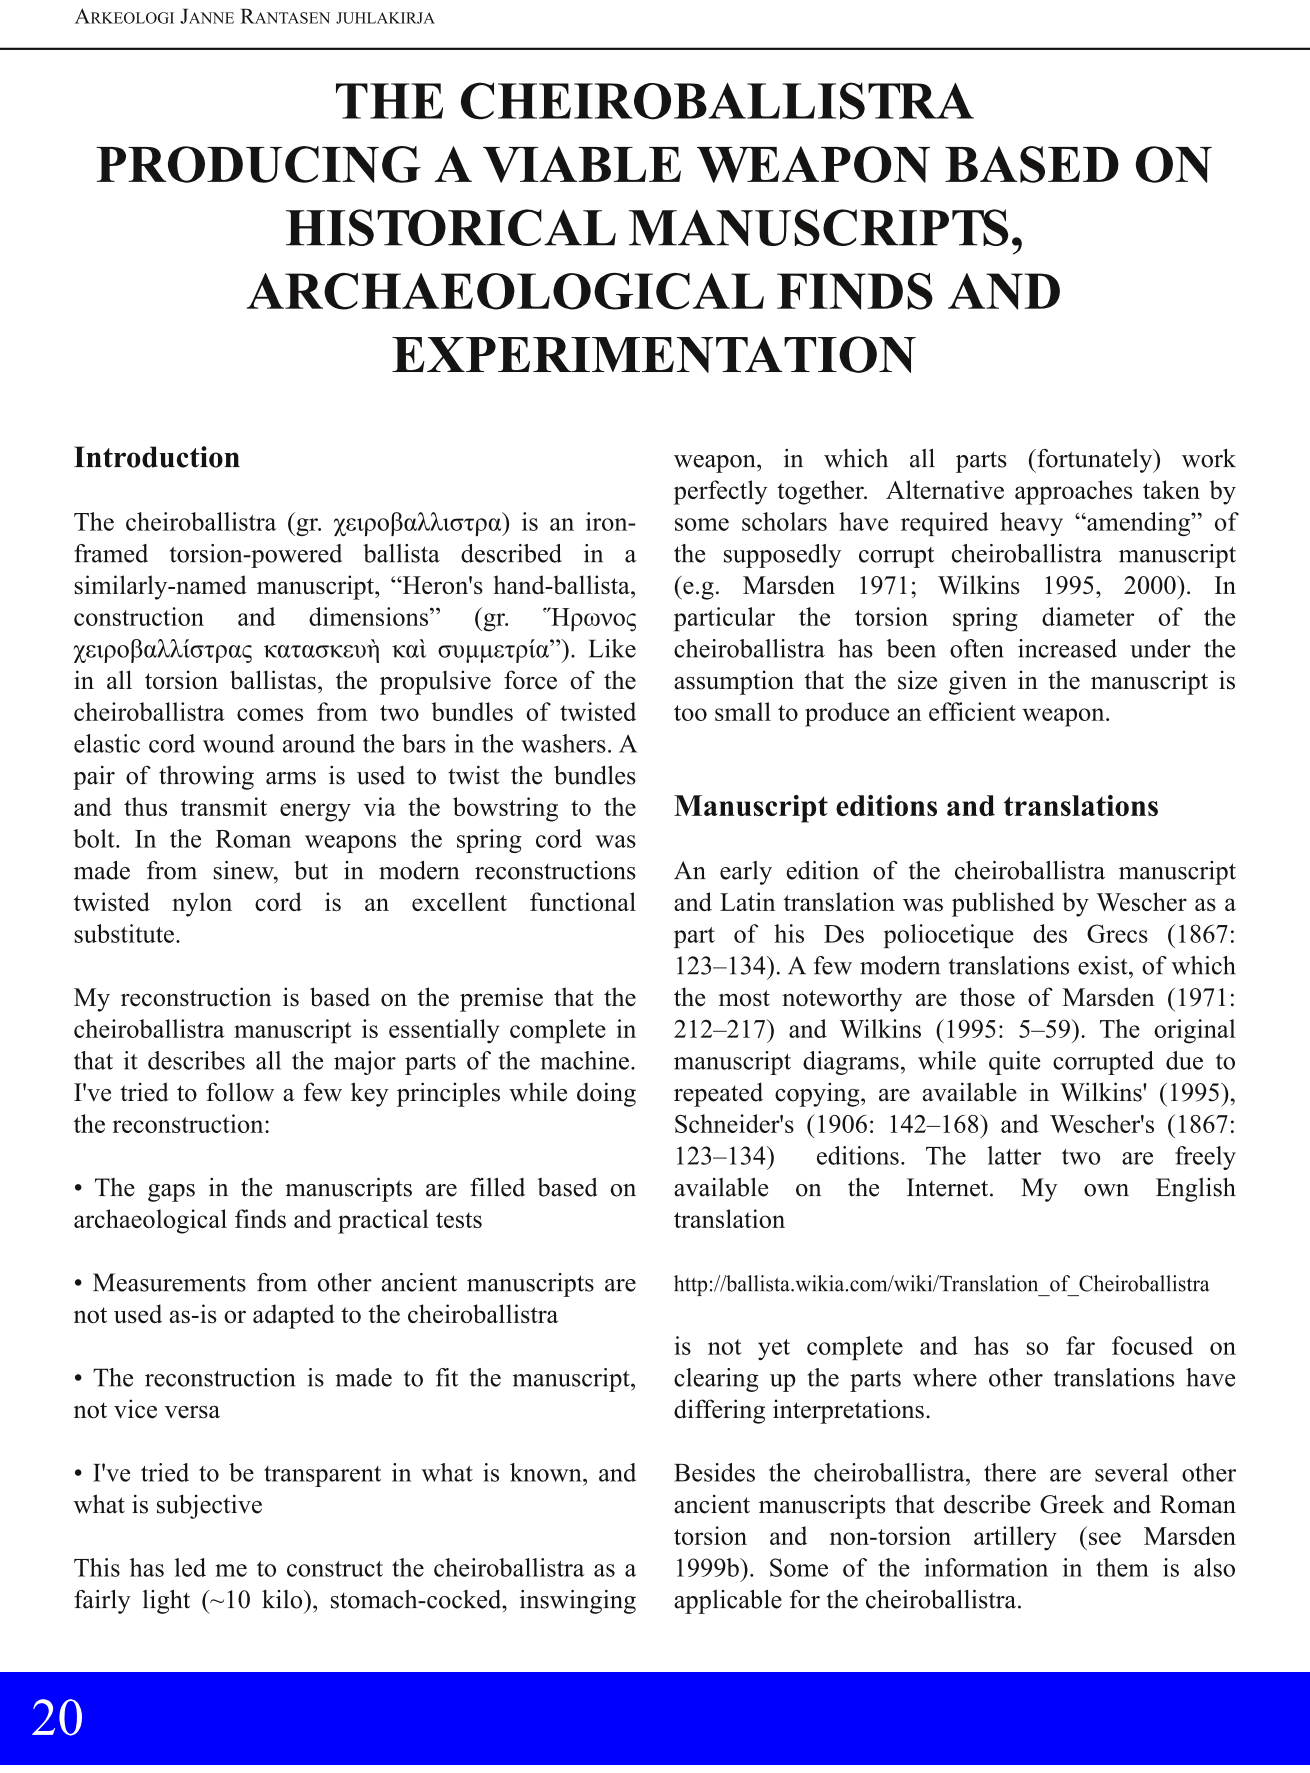
[picture p67: page 1]

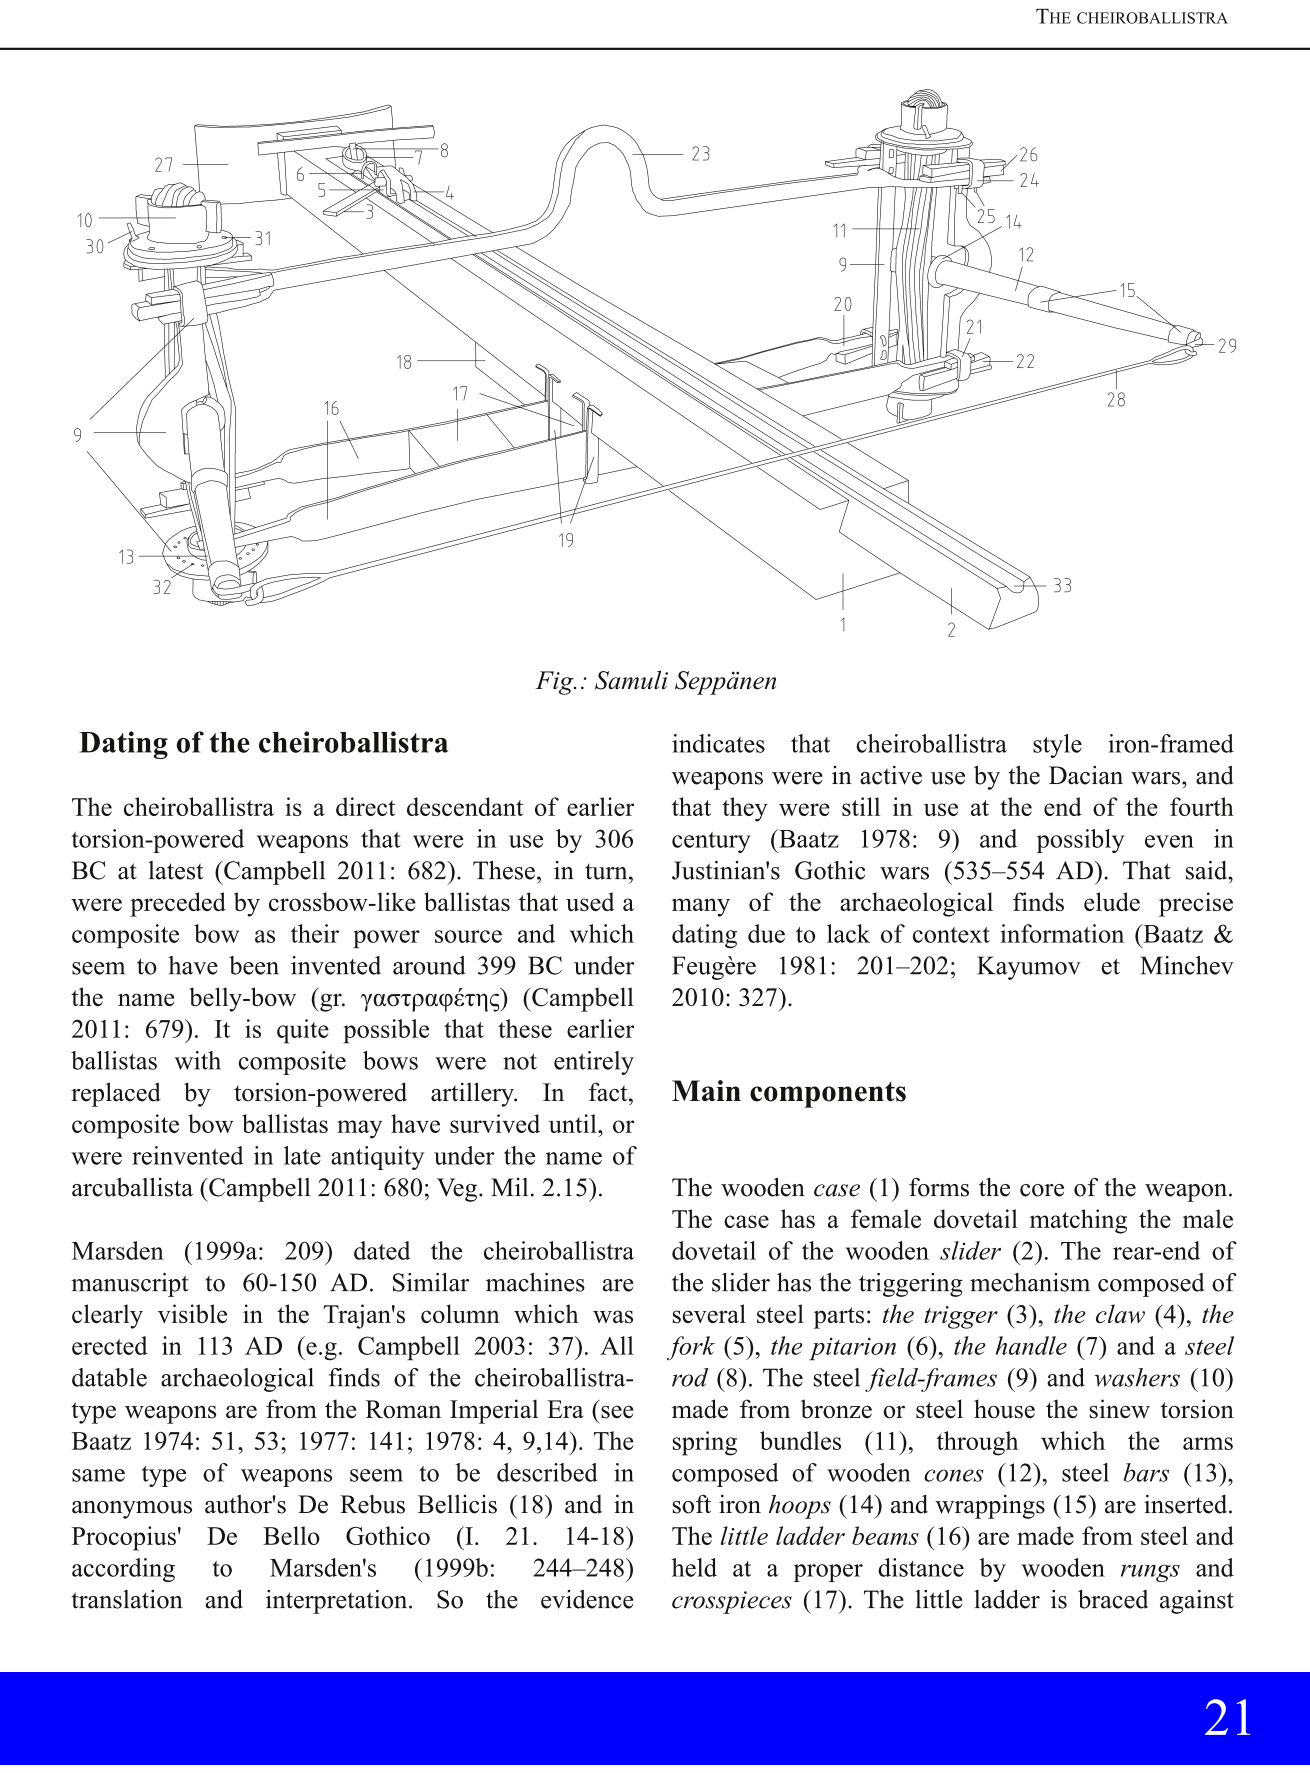
[picture p68: page 2]

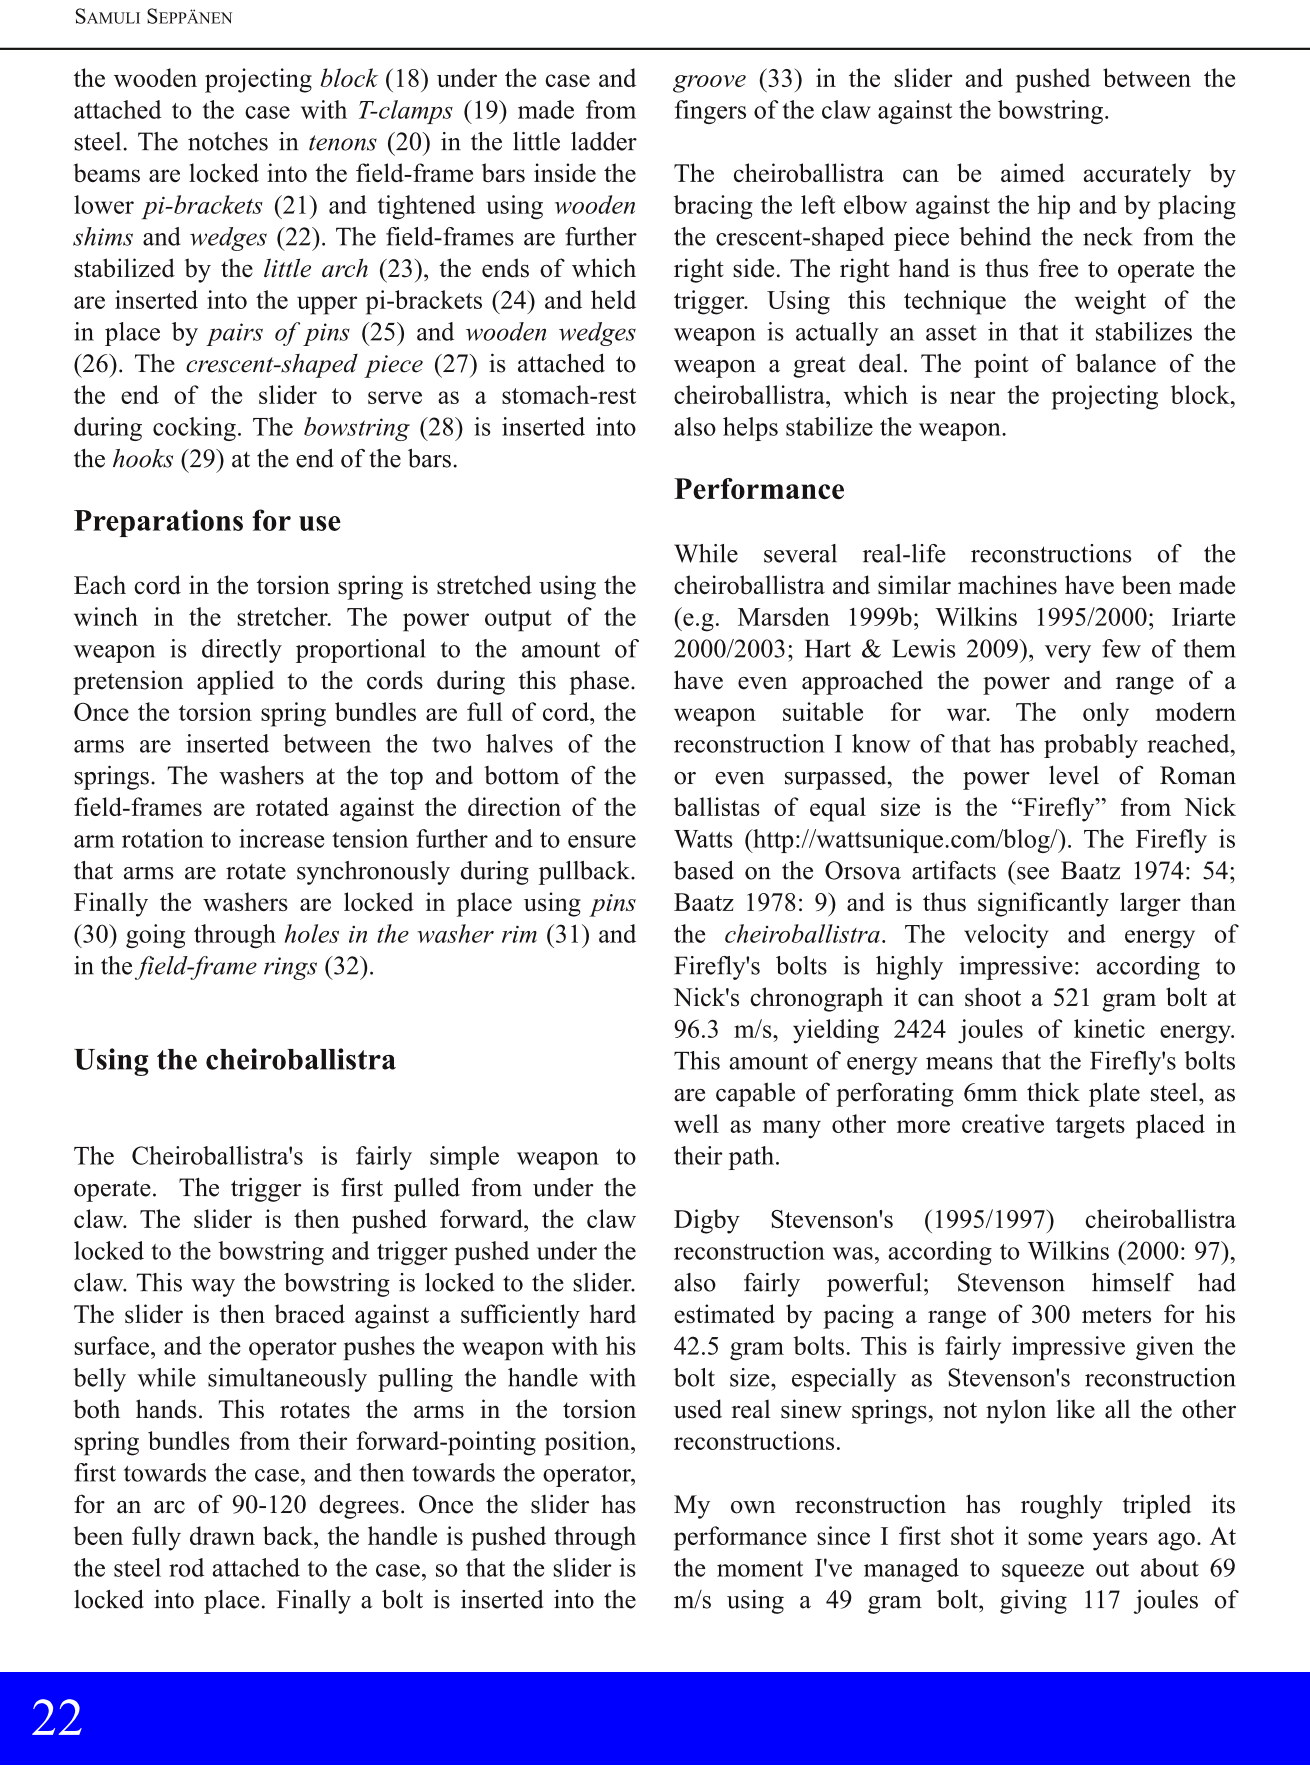
[picture p69: page 3]

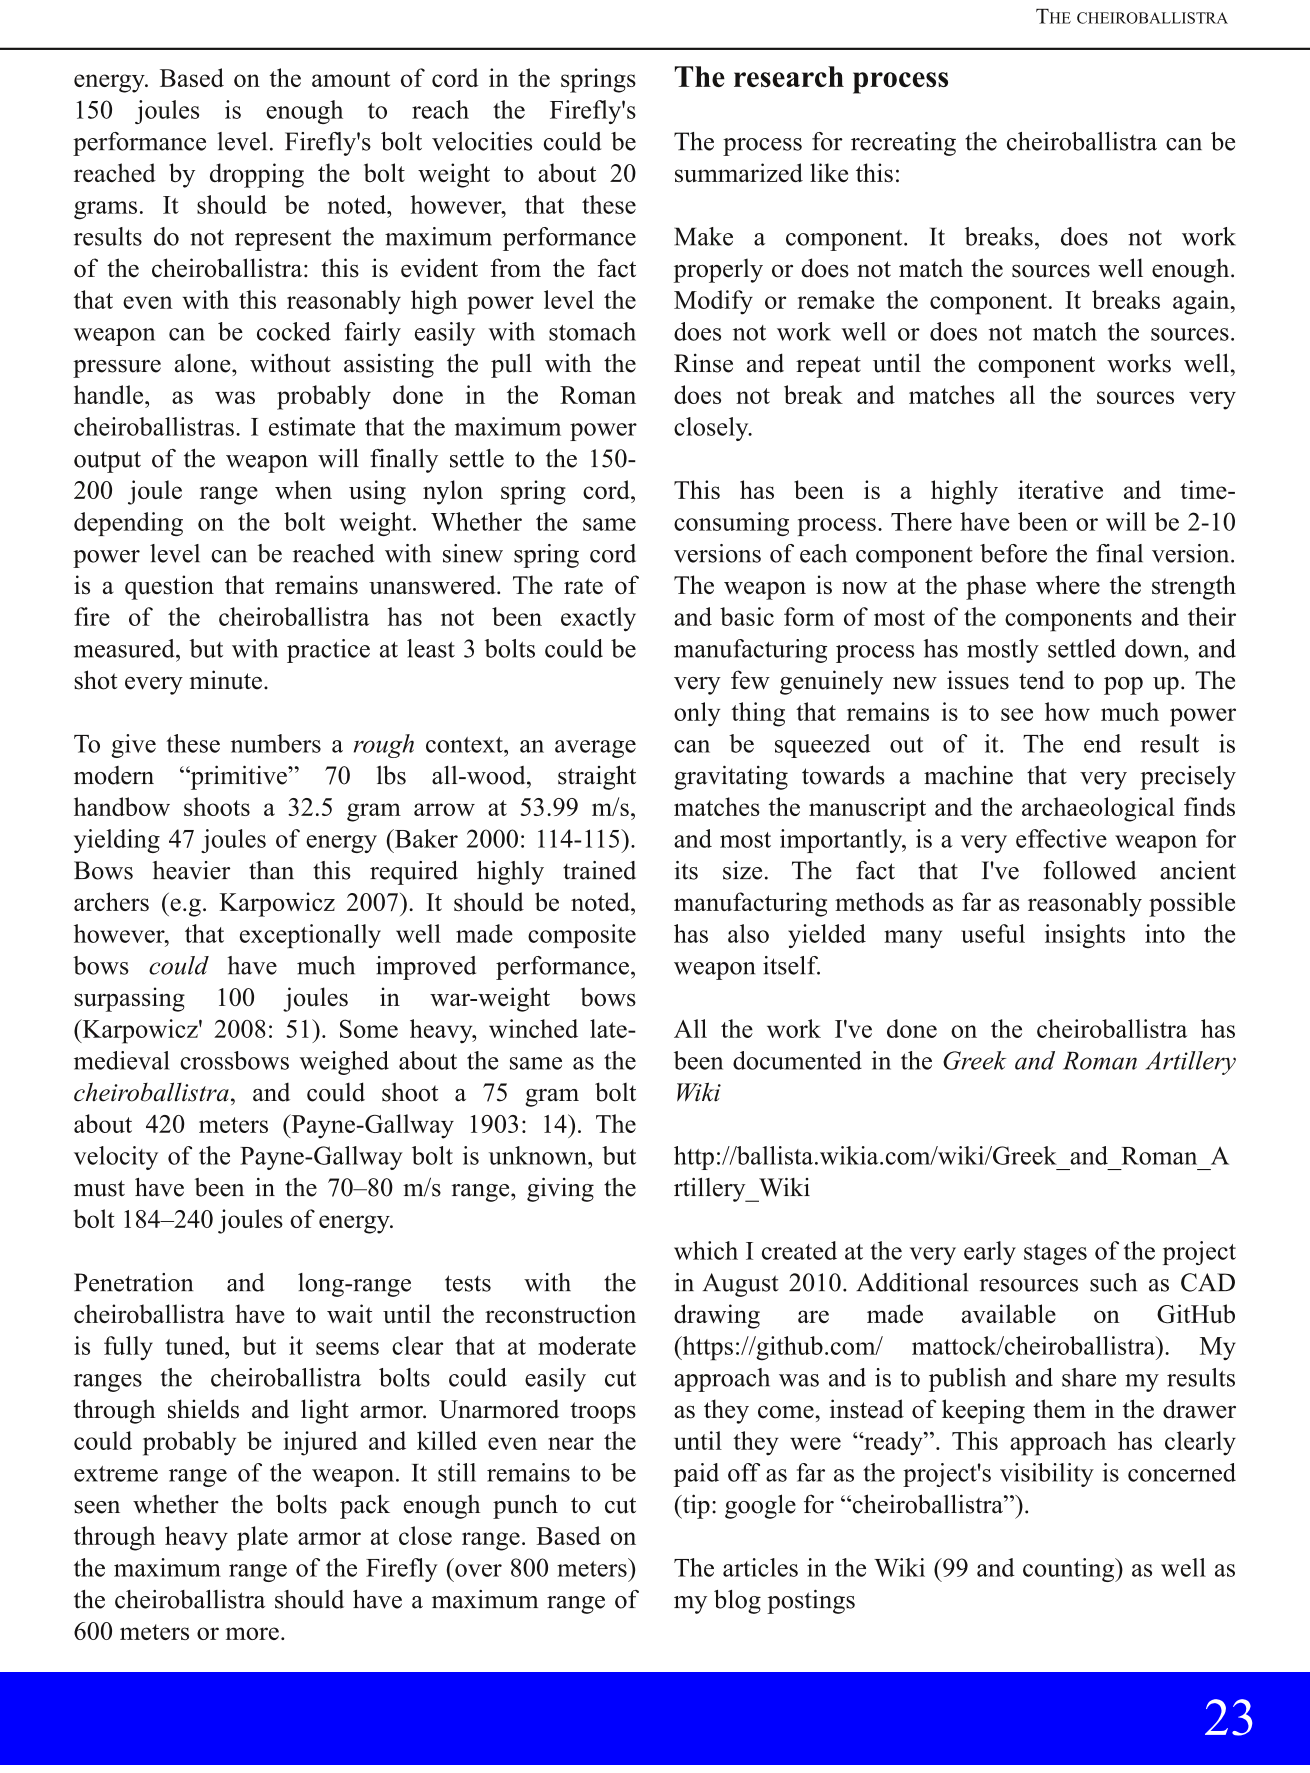
[picture p70: page 4]

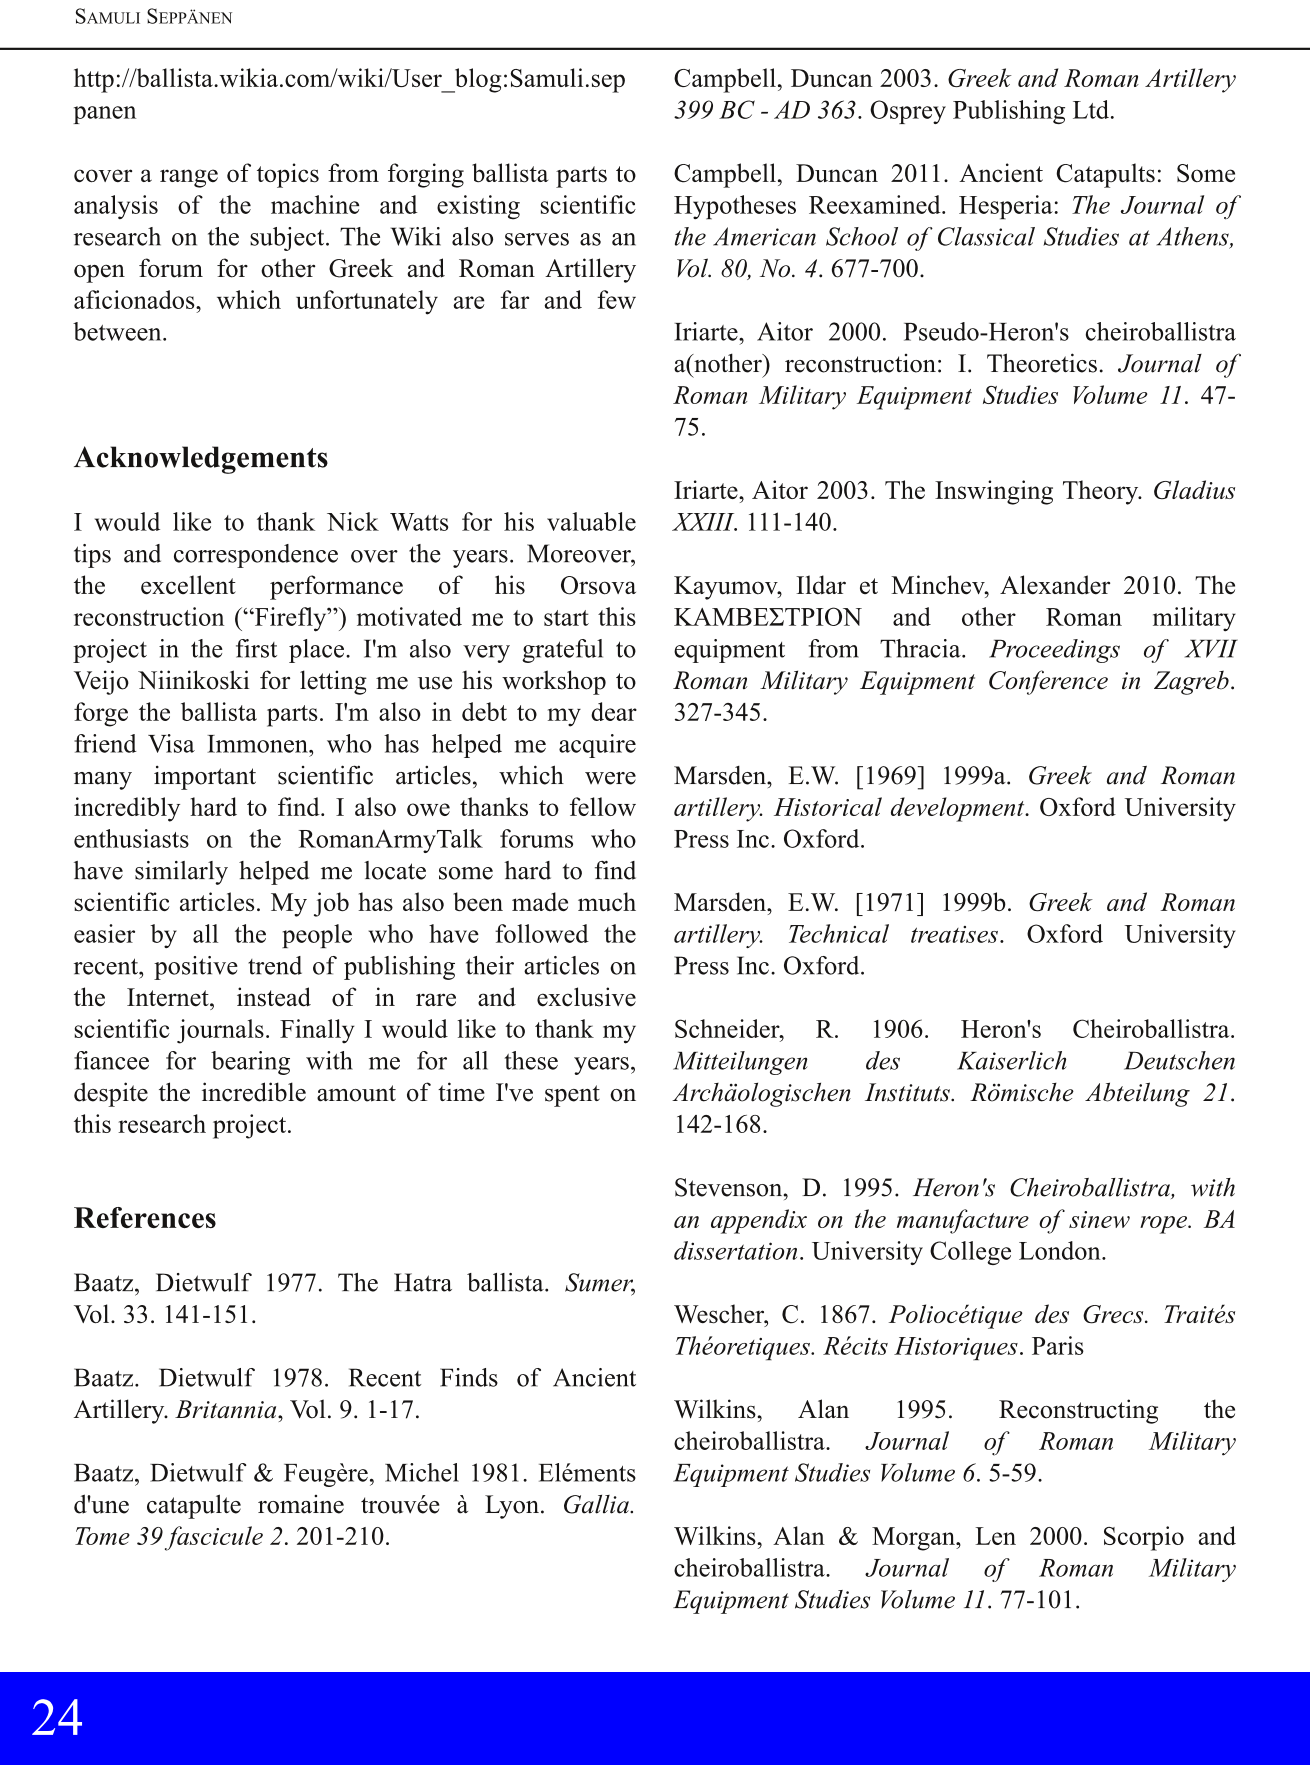
[picture p71: page 5]
