mattock/cheiroballistra/(commit log)

2013-07-07 Initial import to GitHub
    [Cheiroballistra_draw_length_calculations.ods, Cheiroballistra_force-draw_curve_calculations.ods, ballista_bolt_velocities.ods, clip.dxf, cord stretch tests.ods, field-frame bar placement template.dxf, field-frame ring template.dxf, manuballista.dxf]
2013-08-06 Added latest data about the arms, bowstring and shooting results
    [ballista_bolt_velocities.ods]
2013-08-07 Added updated statistics
    [ballista_bolt_velocities.ods]
2013-08-11 Changed slider and case dovetail shape slightly in cheiroballistra.dxf
    [manuballista.dxf]
2013-08-26 New statistics
    [Cheiroballistra_force-draw_curve_calculations.ods, ballista_bolt_velocities.ods]
2013-08-26 New CAD drawings
    [manuballista.dxf]
2013-09-02 Updated wiki backup, statistics and CAD drawings
    [ballista_bolt_velocities.ods, manuballista.dxf]
2013-10-16 Updated cheiroballistra statistics spreadsheet
    [ballista_bolt_velocities.ods]
2013-10-16 Added calibration formulae / archaelogical find comparison spreadsheet
    [formulae and archaeological finds.ods]
2013-10-18 Added CAD drawing that visualizes an outswinging cheiroballistra
    [outswinger visualization.dxf]
2015-01-18 Added cheiroballistra arm design CAD drawing
    This drawing shows the design and dimensions of the arm with all it's
    components. Cross-section is assumed to be a heavily rounded rectangle until
    proven otherwise by tests.
    [Cheiroballistra arm design.dxf, Force-draw curve visualization.dxf]
2015-01-26 Updated Cheiroballistra arm design.dxf
    [Cheiroballistra arm design.dxf]
2015-02-26 Added to-scale CAD drawings of elliptically tillered cheiroballistra cones
    [Cheiroballistra arm - cone - side.dxf]
2015-10-14 Added CAD outline of the cheiroballistra tuned to 320hz
    [320hz ballista overview.dxf]
2015-10-14 Added diagram for a correctly tillered (14d) arm
    [Cheiroballistra arm - cone - side.dxf]
2015-10-14 Updated bolt velocity statistics
    [ballista_bolt_velocities.ods]
2015-10-14 Updated field-frame bar diagrams in the CAD drawing
    [manuballista.dxf]
2015-10-14 Renamed manuballista.dxf to cheiroballistra.dxf
    [cheiroballistra.dxf]
2015-10-15 Updated various parts in cheiroballistra.dxf
    [cheiroballistra.dxf]
2015-10-16 Updates to cheiroballistra.dxf
    [cheiroballistra.dxf]
2015-10-16 Updated cheiroballistra.dxf
    [cheiroballistra.dxf]
2015-10-27 New wiki backup
    [cheiroballistra.dxf]
2015-10-27 Updated cheiroballistra CAD drawing
    [cheiroballistra.dxf]
2015-11-19 Updated CAD drawing for cheiroballistra arms
    The new drawing contains all the useful and necessary features found during
    practical tests.
    [Cheiroballistra arm design.dxf]
2015-11-19 Removed some obsolete documents
    [Cheiroballistra_draw_length_calculations.ods, Cheiroballistra_force-draw_curve_calculations.ods]
2015-11-19 Updated cheiroballistra statistics
    [ballista_bolt_velocities.ods]
2015-11-19 Added a spreadsheet for calculating elliptical tiller for the cones
    [Cone taper calculator.ods]
2015-11-19 Added an article about the Cheiroballistra by Samuli Seppänen
    [320hz ballista overview.dxf]
2015-11-19 Added abstract and print version of the article
2015-11-20 Added a document with references missing from the print article
2015-11-20 Add print version of the article with an addendum
2015-11-29 Updated cheiroballistra arm CAD drawings
    [Cheiroballistra arm - cone - side.dxf, Cheiroballistra arm design.dxf]
2015-12-24 Update non-print PDF version of the Juhlakirja article to the latest version
2016-01-12 Updated little ladder and little arch in cheiroballistra.dxf
    [cheiroballistra.dxf]
2017-01-01 Updated ballista statistics
    [ballista_bolt_velocities.ods]
2017-08-19 Update line width for printable cheiroballistra arms
    [Cheiroballistra arm design.dxf]
2017-08-24 Add layer which shows cheiroballistra arm thickness for printing
    [Cheiroballistra arm design.dxf]
2018-07-06 Update cheiroballistra statistics document with new data
    [ballista_bolt_velocities.ods]
2019-01-21 Update ballista statistics spreadsheet
    [ballista_bolt_velocities.ods]
